dragino/NB-IoT/(threads)

Thread 1 (2018-11-22):

NB-IoT UDP communacation problem

mhmtkrl, 2018-11-22:
Hi,

Thank you for sharing information. I have a quectel BC95-G nb-iot dev board. I followed your tutorial. I created lua script and I tried to send udp message from my nb-iot devices but I didn't success. After send AT+NSOST command, the return value is [socket],[length], OK. I don't receive the "+NSONMI”. I chose the IPv4 address of my computer. AT+CEREG's return value is "+CEREG:1,9129,0AAE9CA1,9", according to this value registration has done. But I need a help.

Thank you in advance.
