dragino/NB-IoT/NB-IoT Shield/hardware/IoT Shield/v1.2/IoT Shield.v1.2 SCH.pdf

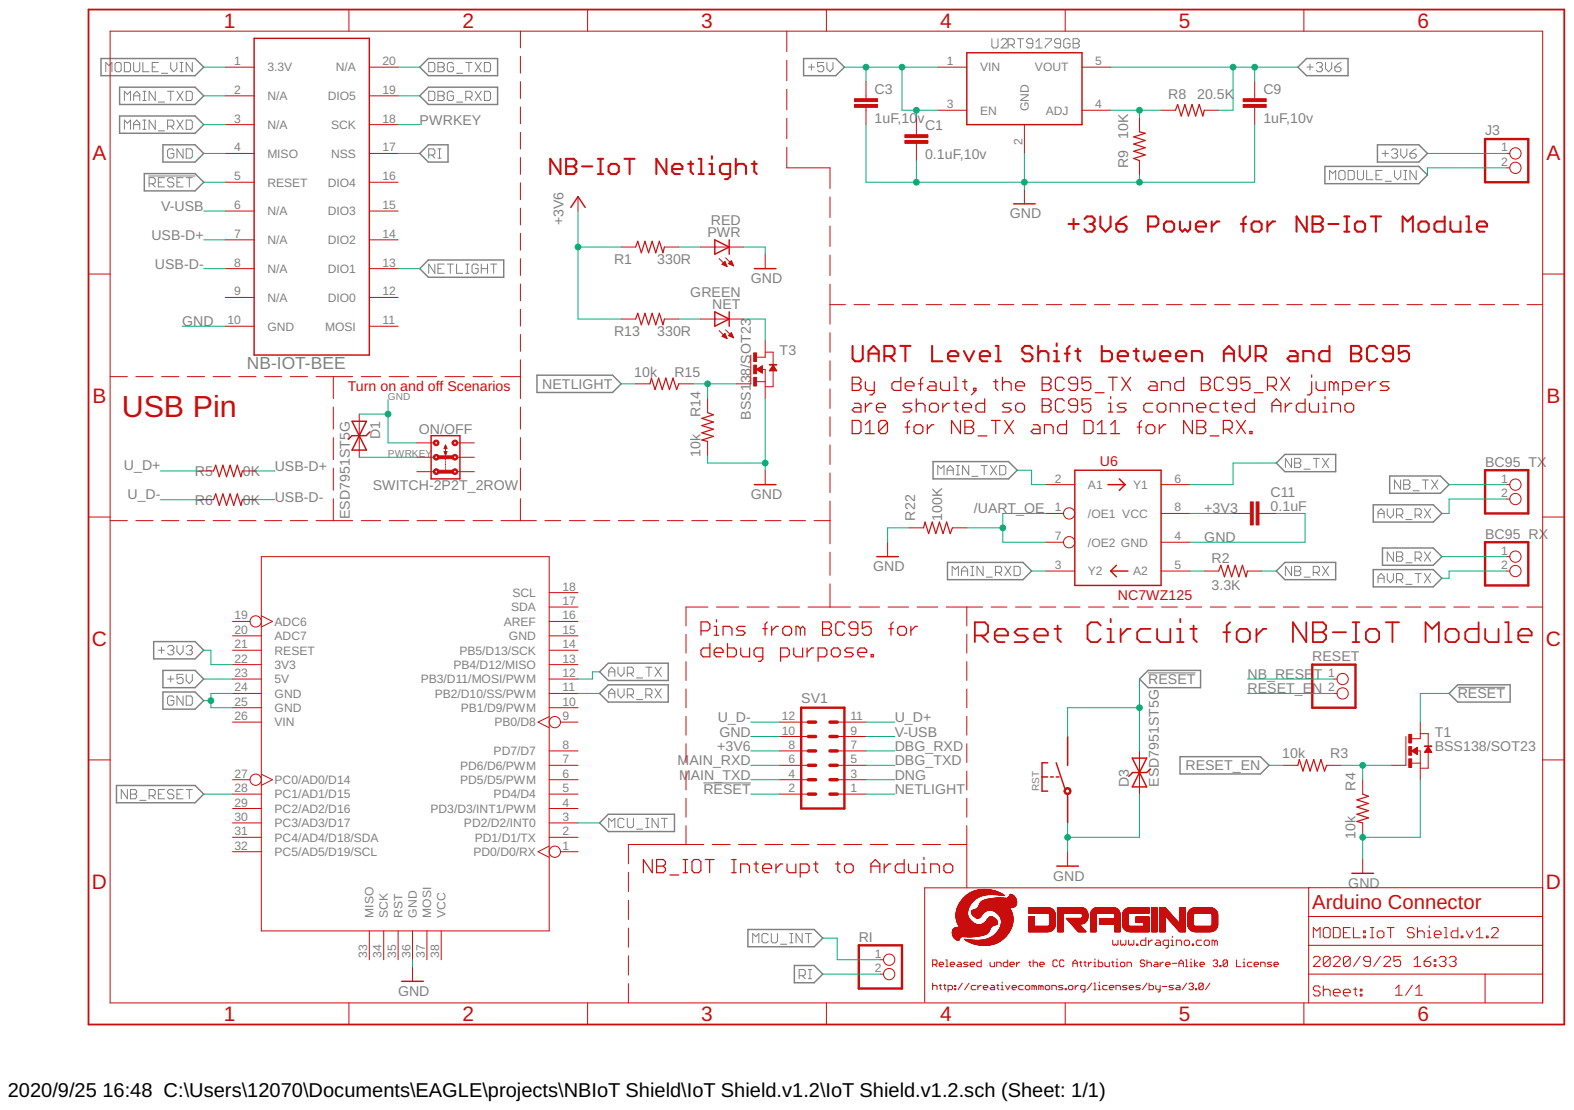
[picture p1: page 1]

Turn on and off Scenarios

2020/9/25 16:48 C:\Users\12070\Documents\EAGLE\projects\NBIoT Shield\IoT Shield.v1.2\IoT Shield.v1.2.sch (Sheet: 1/1)
