dragino/NB-IoT/NB-IoT Shield/hardware/IoT Shield/v1.2/IoT Shield.v1.2 top_silkscreen.pdf

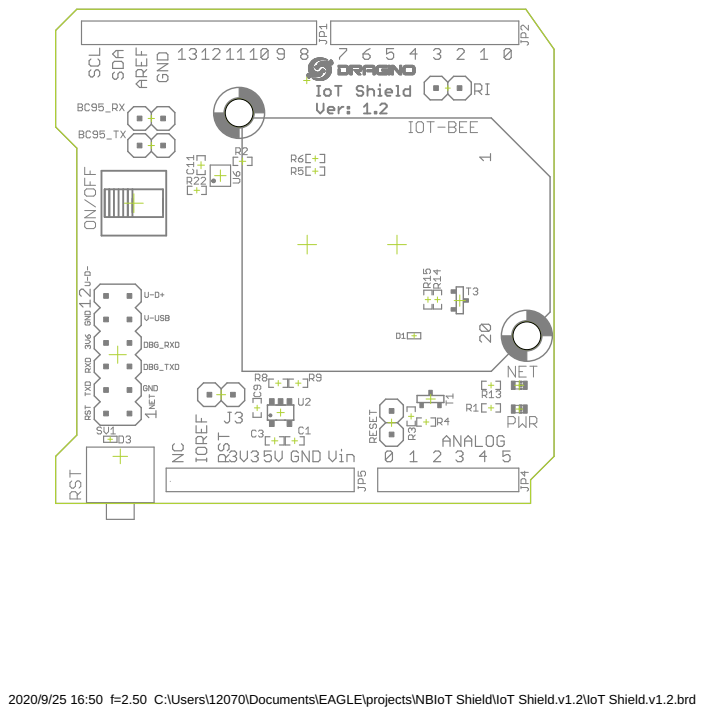
[picture p2: page 1]

2020/9/25 16:50 f=2.50 C:\Users\12070\Documents\EAGLE\projects\NBIoT Shield\IoT Shield.v1.2\IoT Shield.v1.2.brd
