dragino/NB-IoT/NB-IoT Shield/hardware/NB-IoT Bee/v96_5/NB-IoT Bee.v96_5.sch.pdf

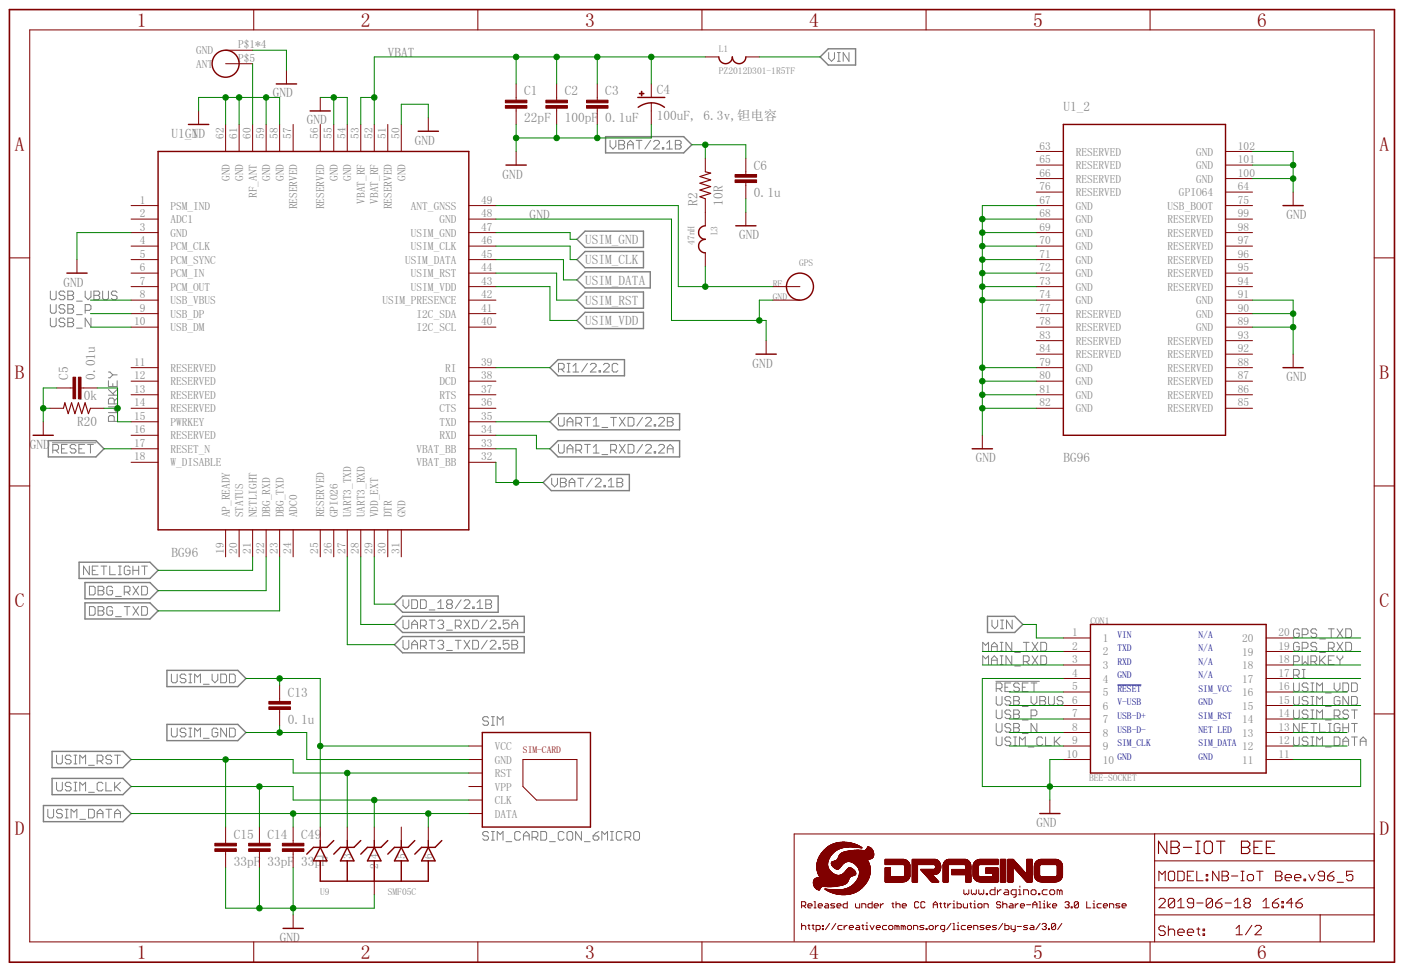
[picture p3: page 1]

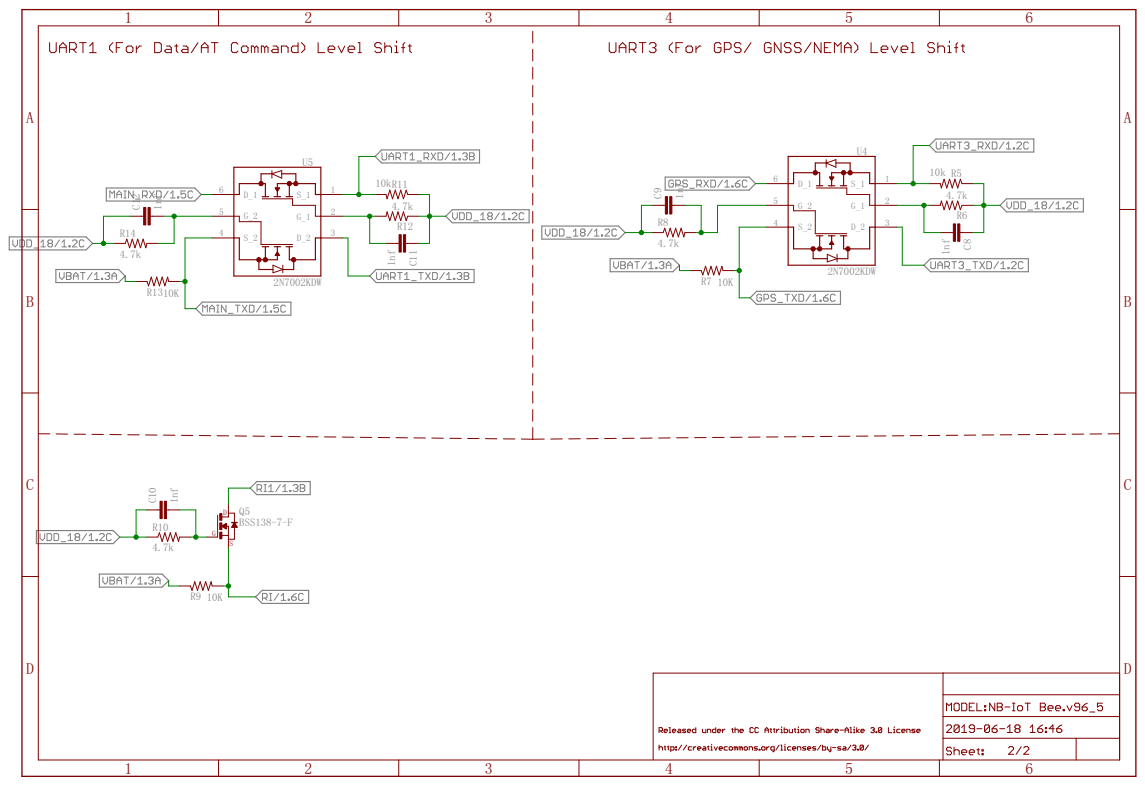
[picture p4: page 2]
