dragino/NB-IoT/NB ST/BG95-NGFF v1.0/BG95-NGFF v1.0 bottom_silkscreen.pdf

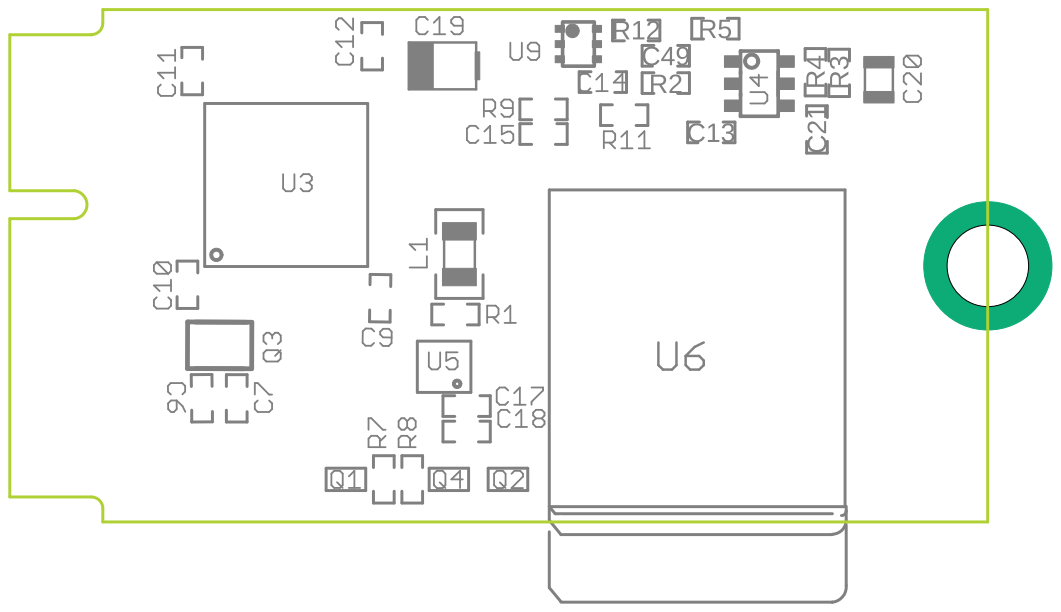
[picture p5: page 1]
