dragino/NB-IoT/NB ST/BG95-NGFF v1.0/BG95-NGFF v1.0 topsilkscreen.pdf

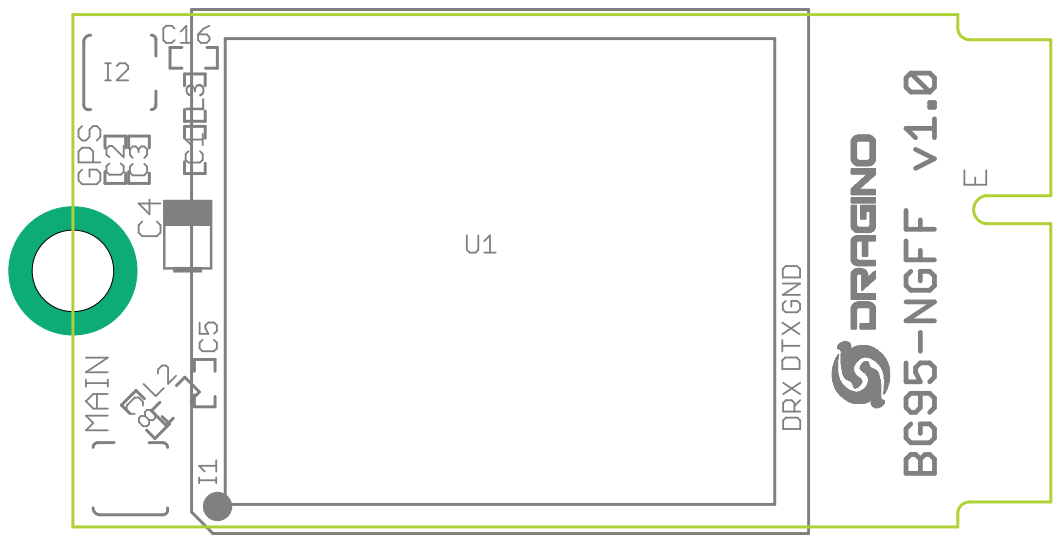
[picture p6: page 1]
