dragino/NB-IoT/NB ST/BG95-NGFF v1.0/BG95-NGFF v1.0.sch.pdf

A

A

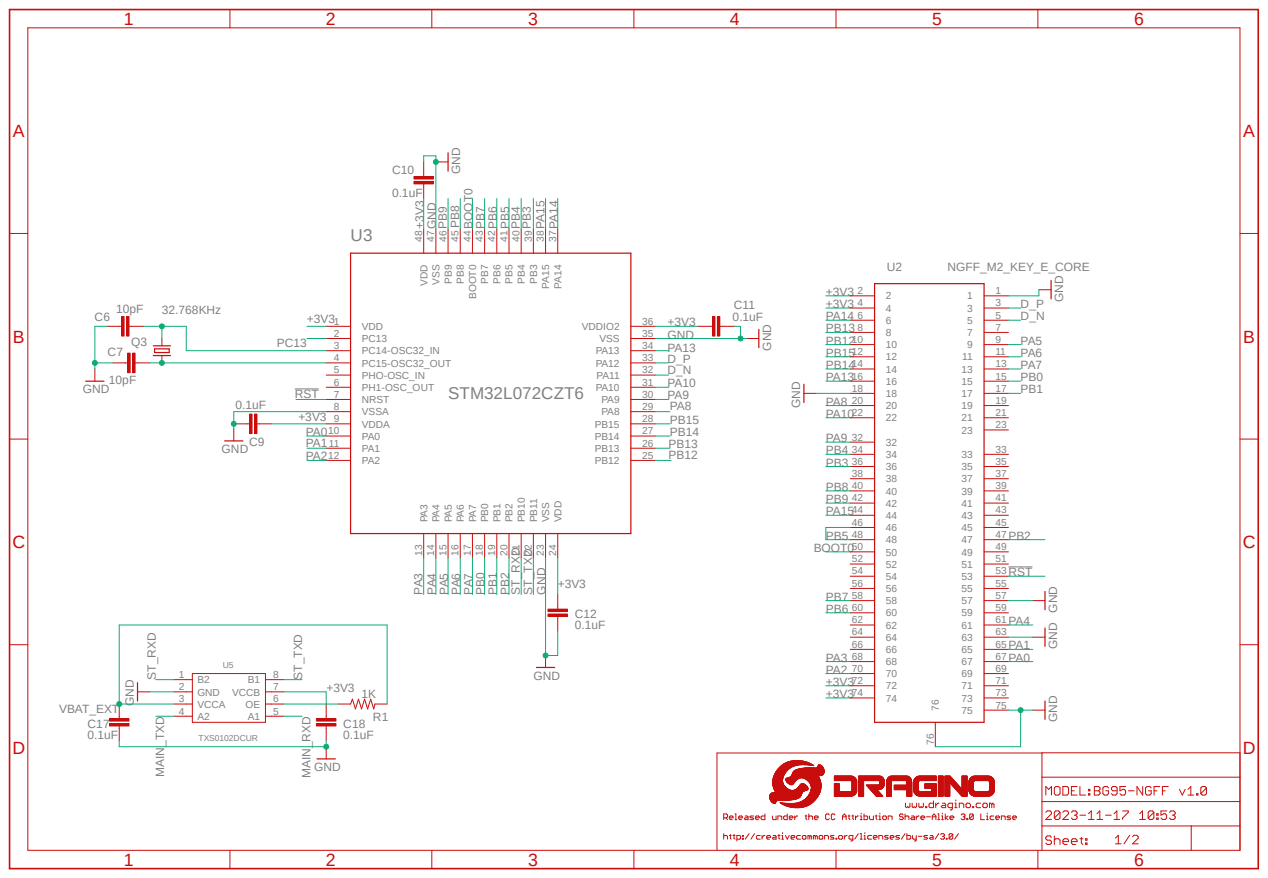
[picture p7: page 1]

A

A

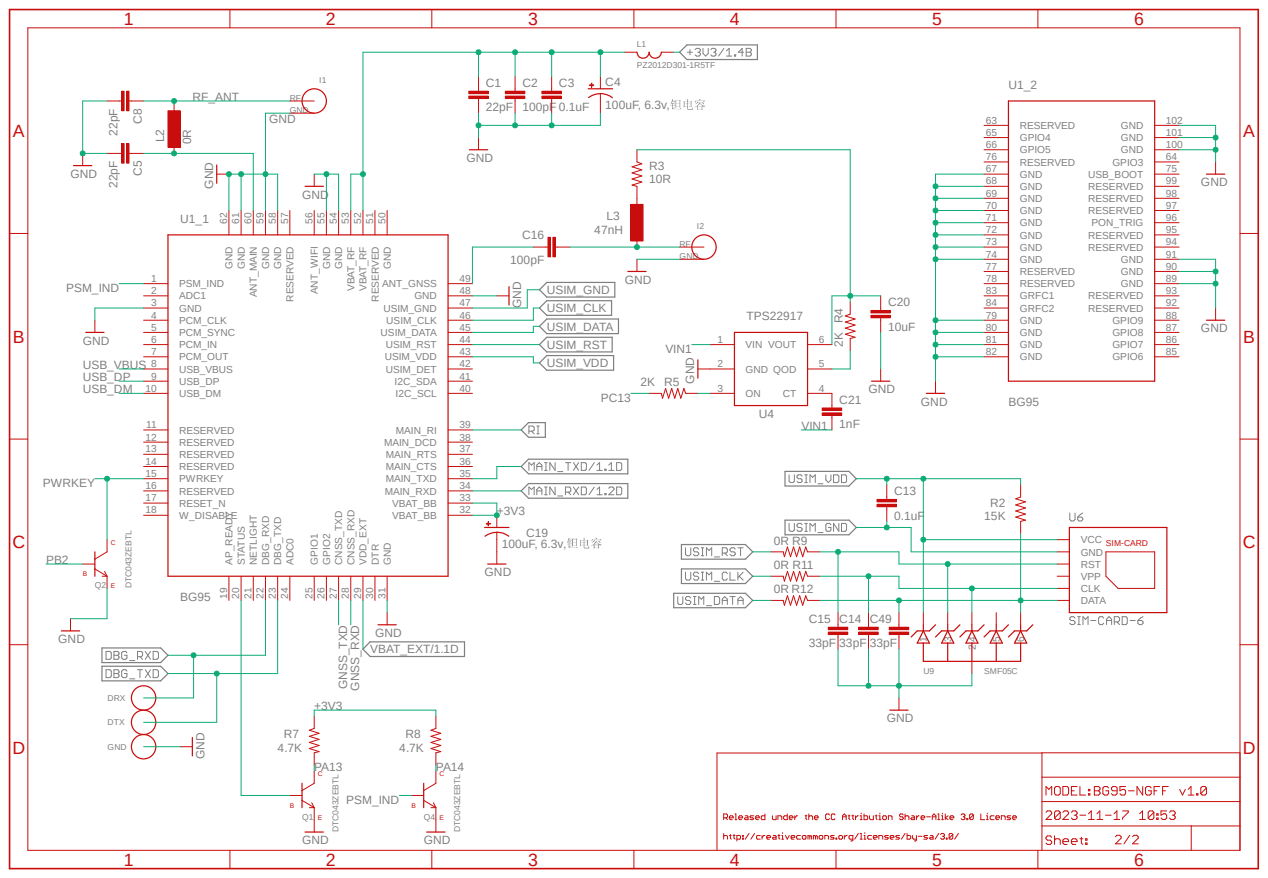
[picture p8: page 2]
