dragino/NB-IoT/NB ST/BC660K-GL/v1.3/NB ST v1.3-BC660K-GL bottom_silkscreen.pdf

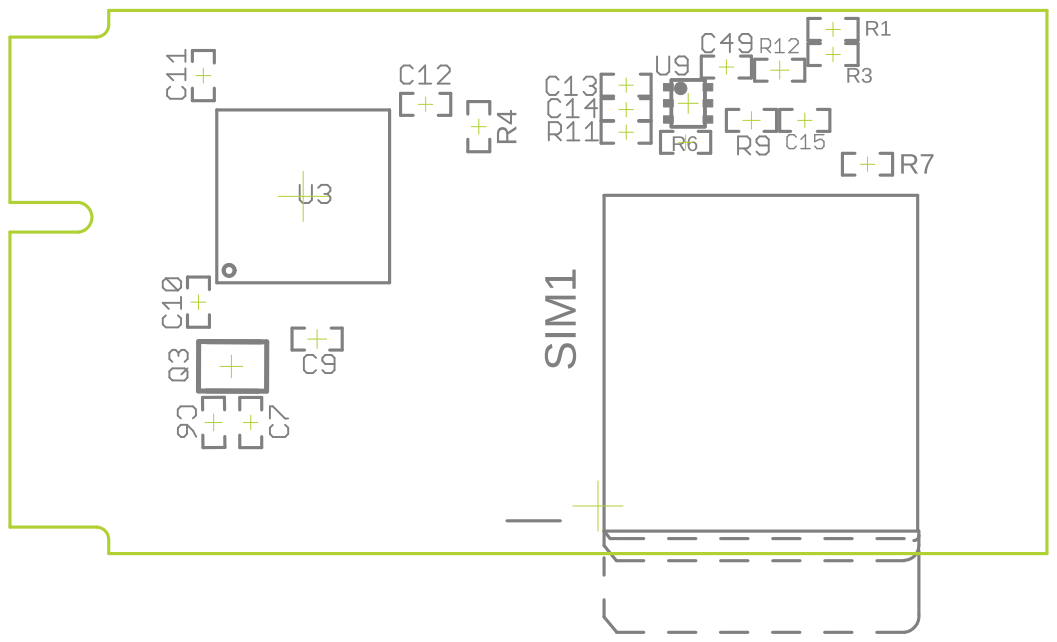
[picture p9: page 1]
