dragino/NB-IoT/NB ST/BC660K-GL/v1.3/NB ST v1.3-BC660K-GL top_silkscreen.pdf

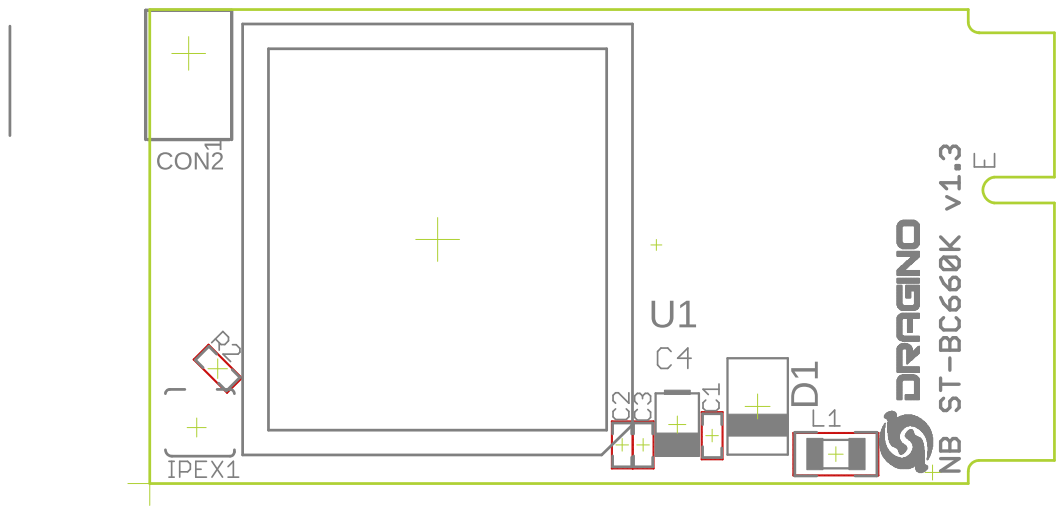
[picture p10: page 1]
