dragino/NB-IoT/NB ST/BC660K-GL/v1.3/NB ST v1.3-BC660K-GL.sch.pdf

A

A

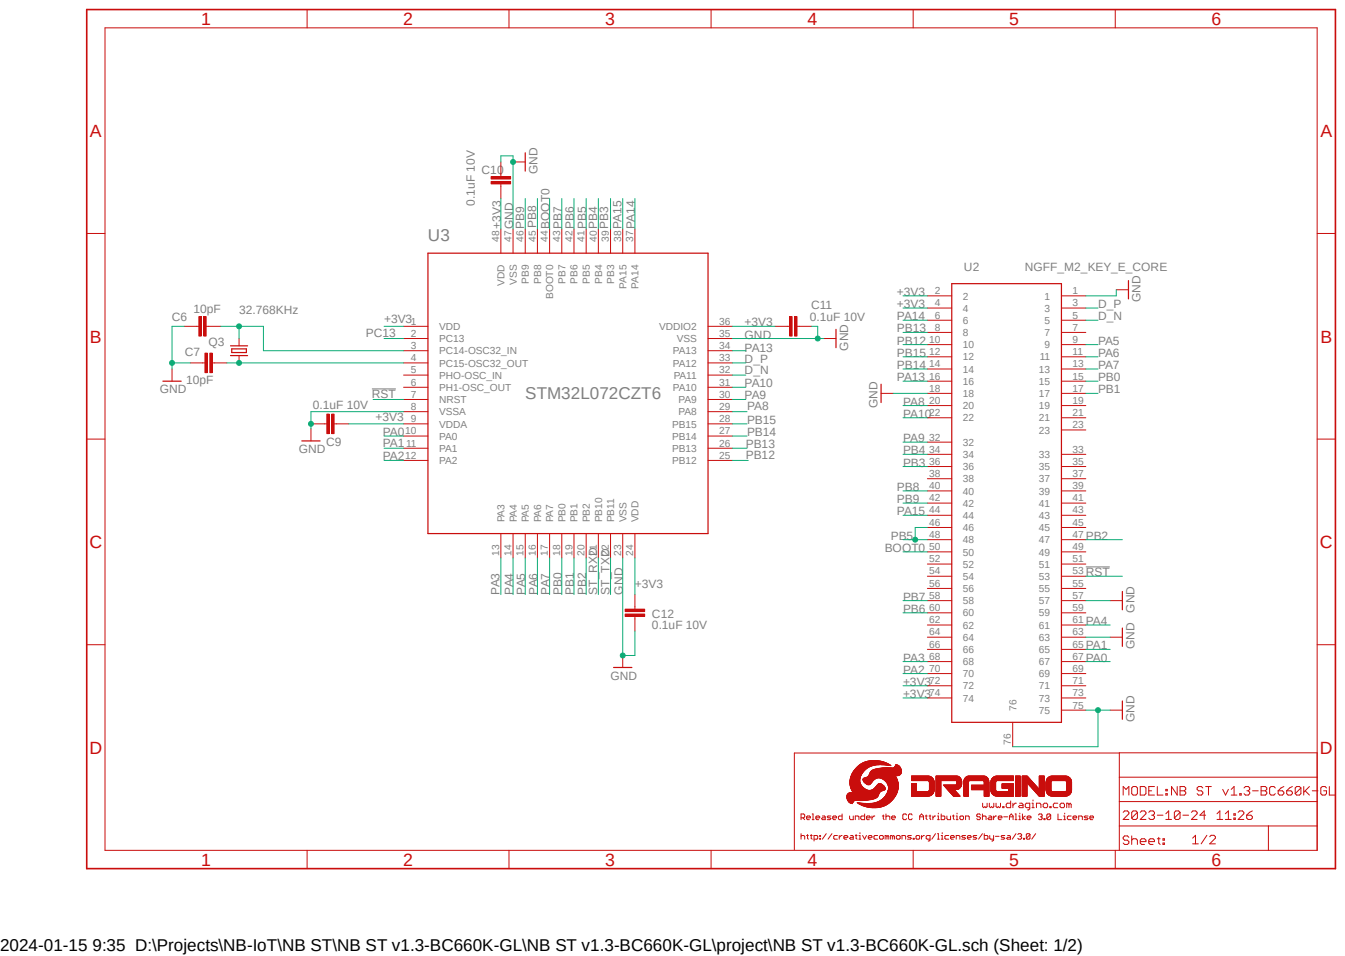
[picture p11: page 1]

2024-01-15 9:35 D:\Projects\NB-IoT\NB ST\NB ST v1.3-BC660K-GL\NB ST v1.3-BC660K-GL\project\NB ST v1.3-BC660K-GL.sch (Sheet: 1/2)

A

A

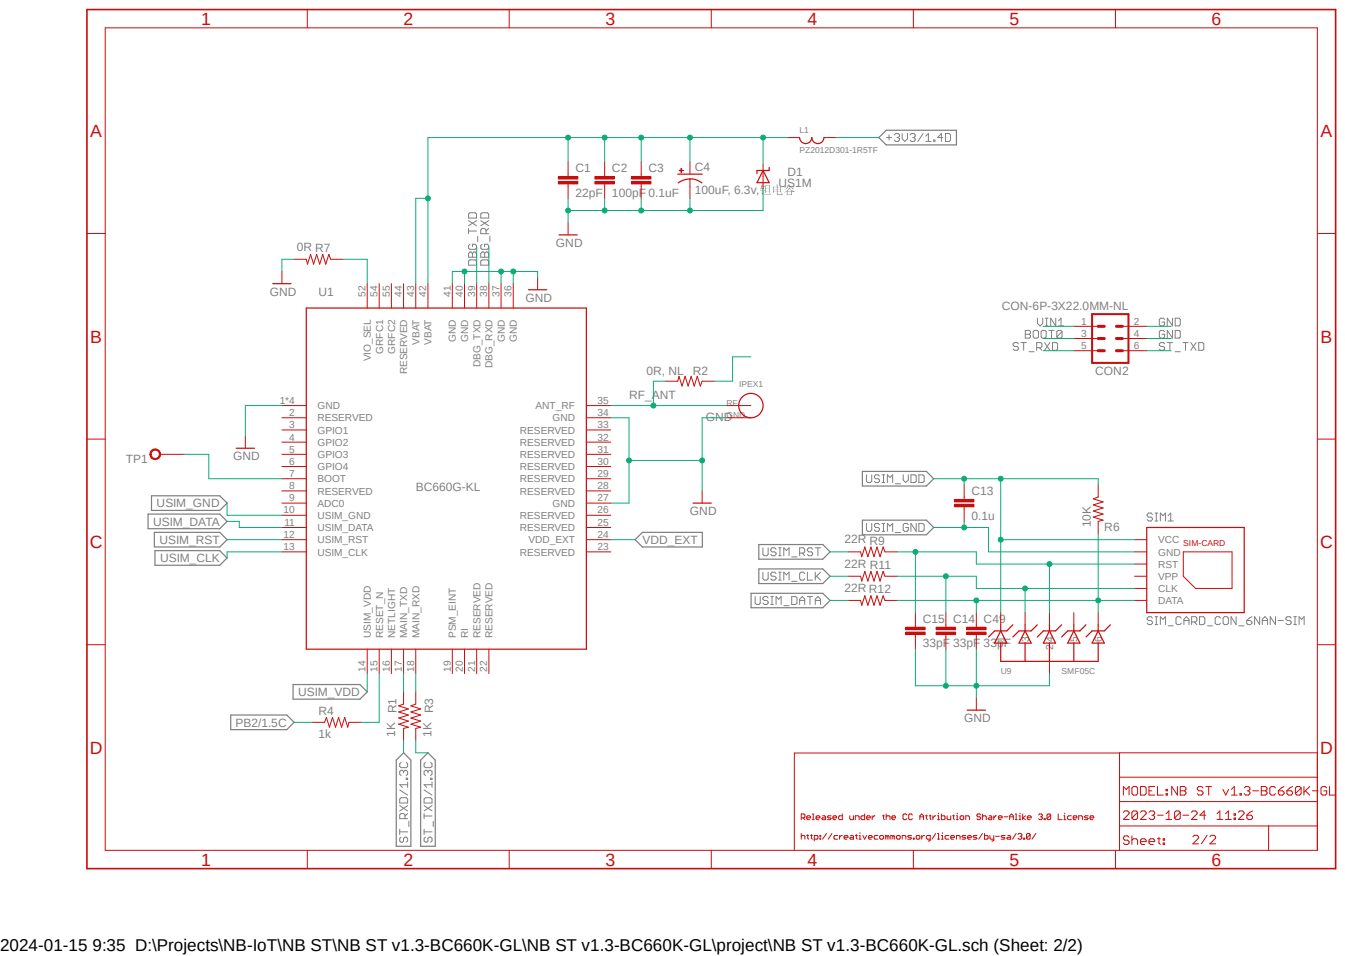
[picture p12: page 2]

2024-01-15 9:35 D:\Projects\NB-IoT\NB ST\NB ST v1.3-BC660K-GL\NB ST v1.3-BC660K-GL\project\NB ST v1.3-BC660K-GL.sch (Sheet: 2/2)
