dragino/NB-IoT/NB ST/BC95/v1.1/NB ST v1.1 bottomsilkscreen.pdf

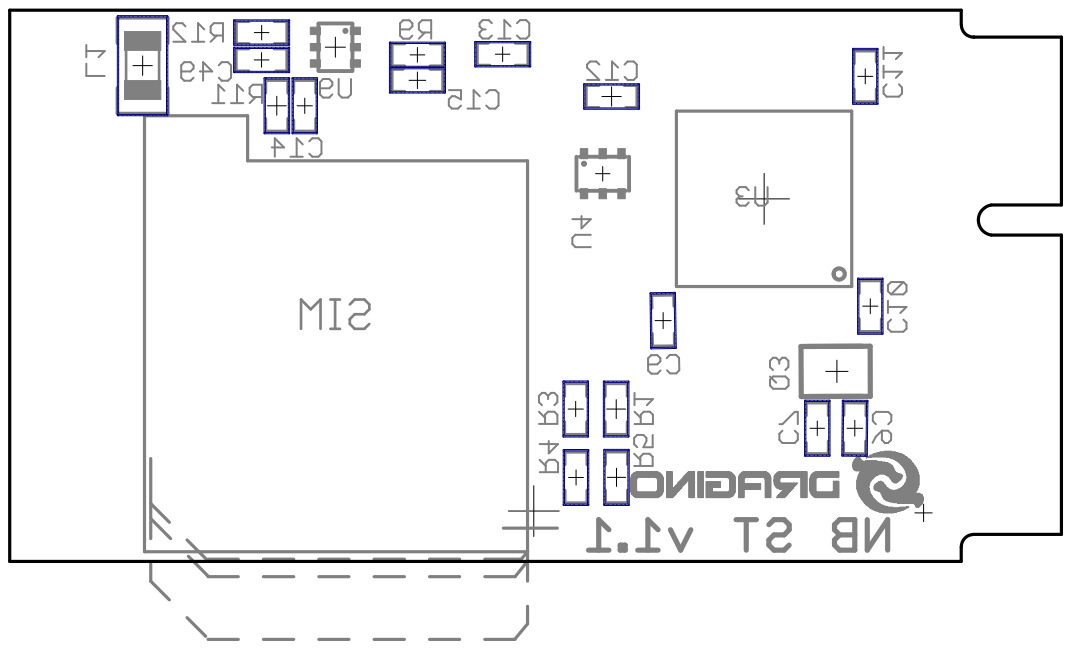
[picture p13: page 1]
