dragino/NB-IoT/NB ST/BC95/v1.1/NB ST v1.1 topsilkscreen.pdf

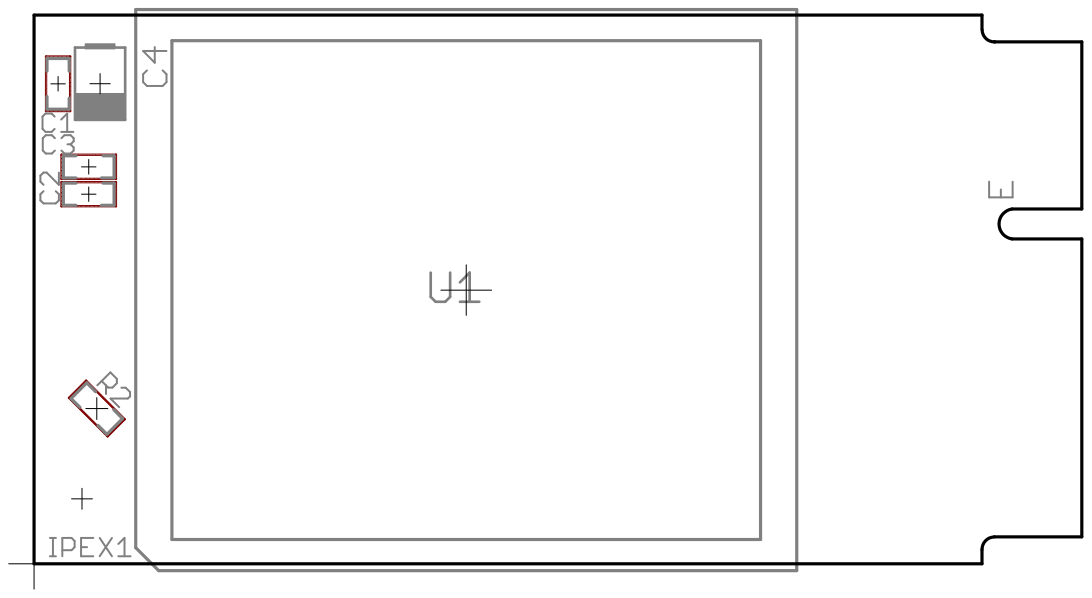
[picture p14: page 1]
