dragino/NB-IoT/NB ST/BC95/v1.1/NB ST v1.1.sch.pdf

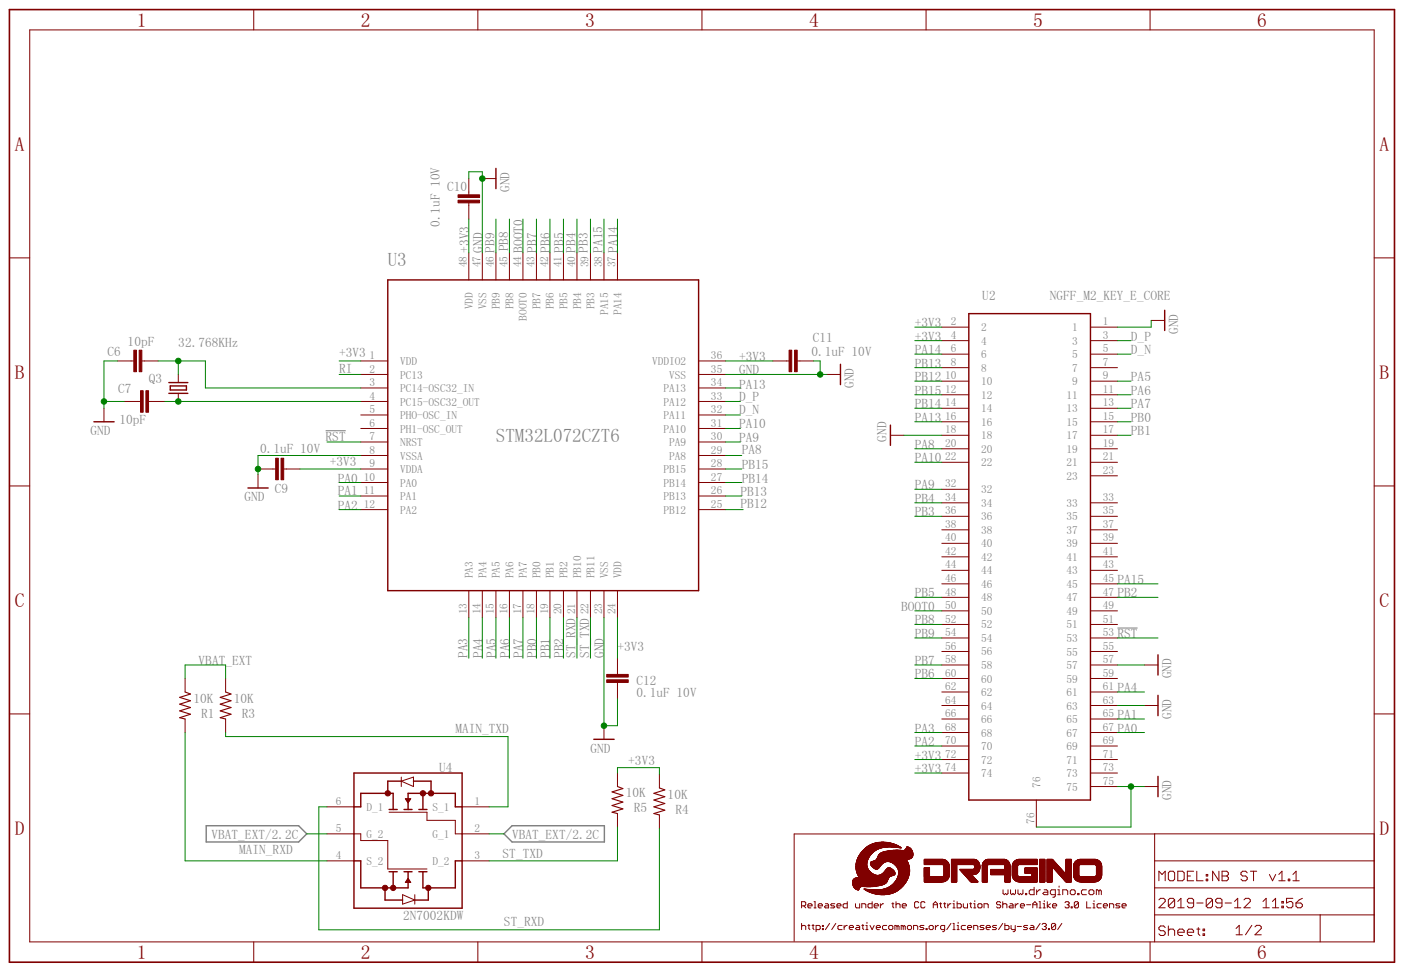
[picture p15: page 1]

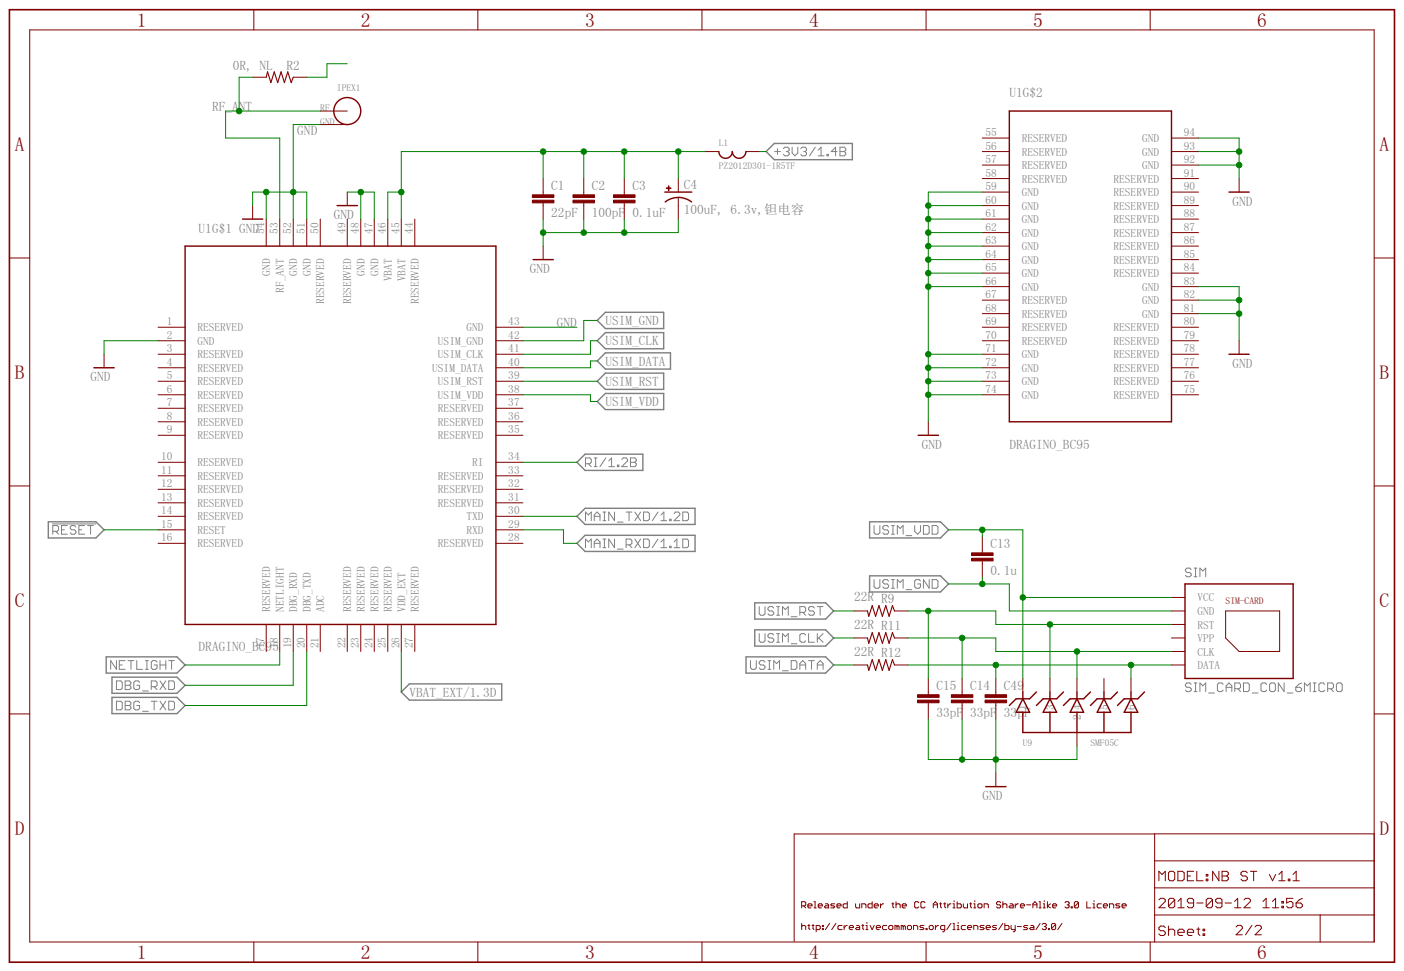
[picture p16: page 2]
