dragino/NB-IoT/NB-IoT Shield/hardware/NB-IoT Bee/v96_4/NB-IoT Bee.v96_4.bot.silkscreen.pdf

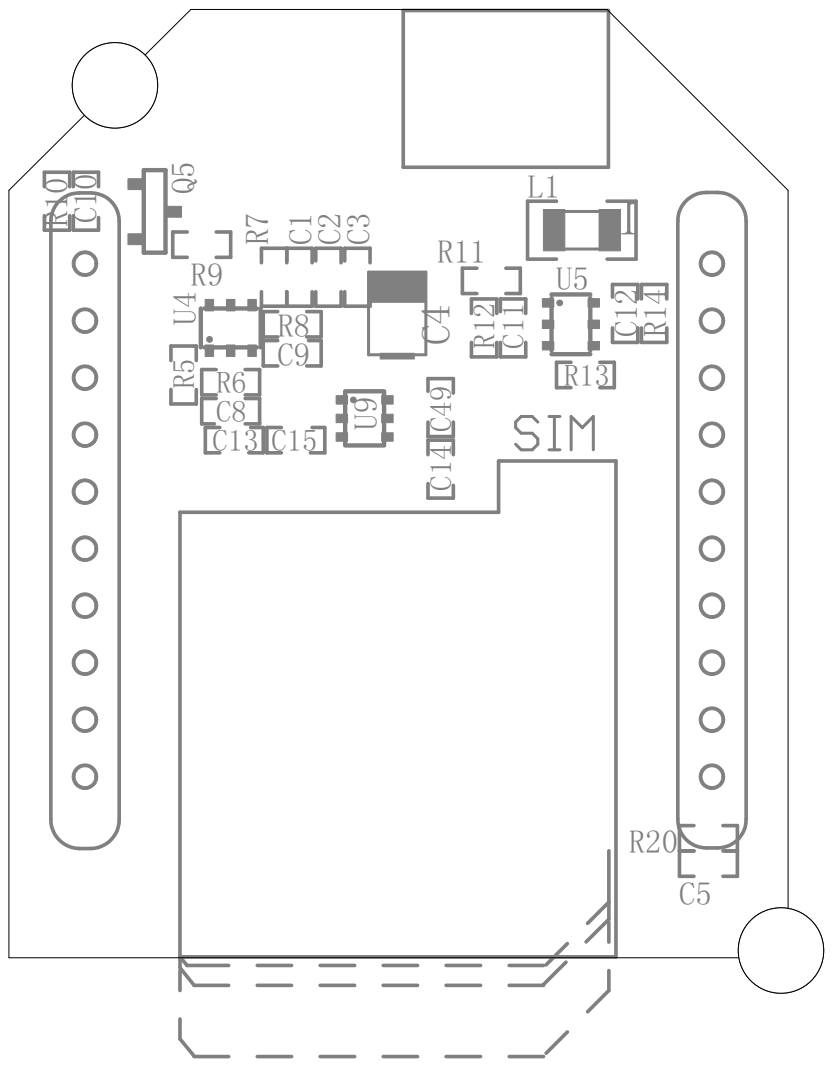
[picture p17: page 1]
