dragino/NB-IoT/NB-IoT Shield/hardware/NB-IoT Bee/v96_4/NB-IoT Bee.v96_4.sch.pdf

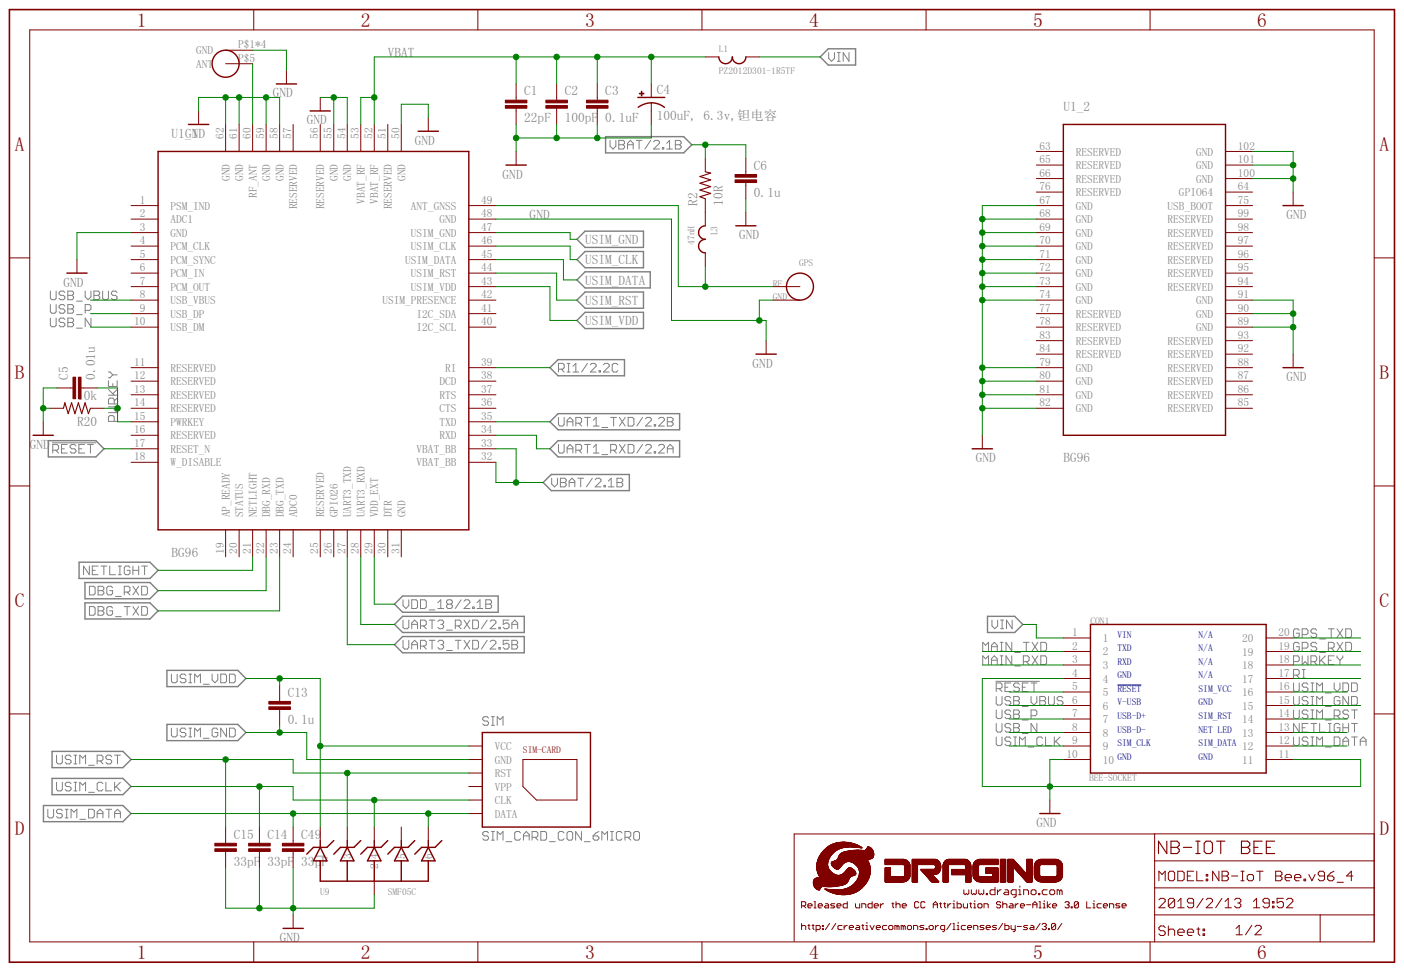
[picture p18: page 1]

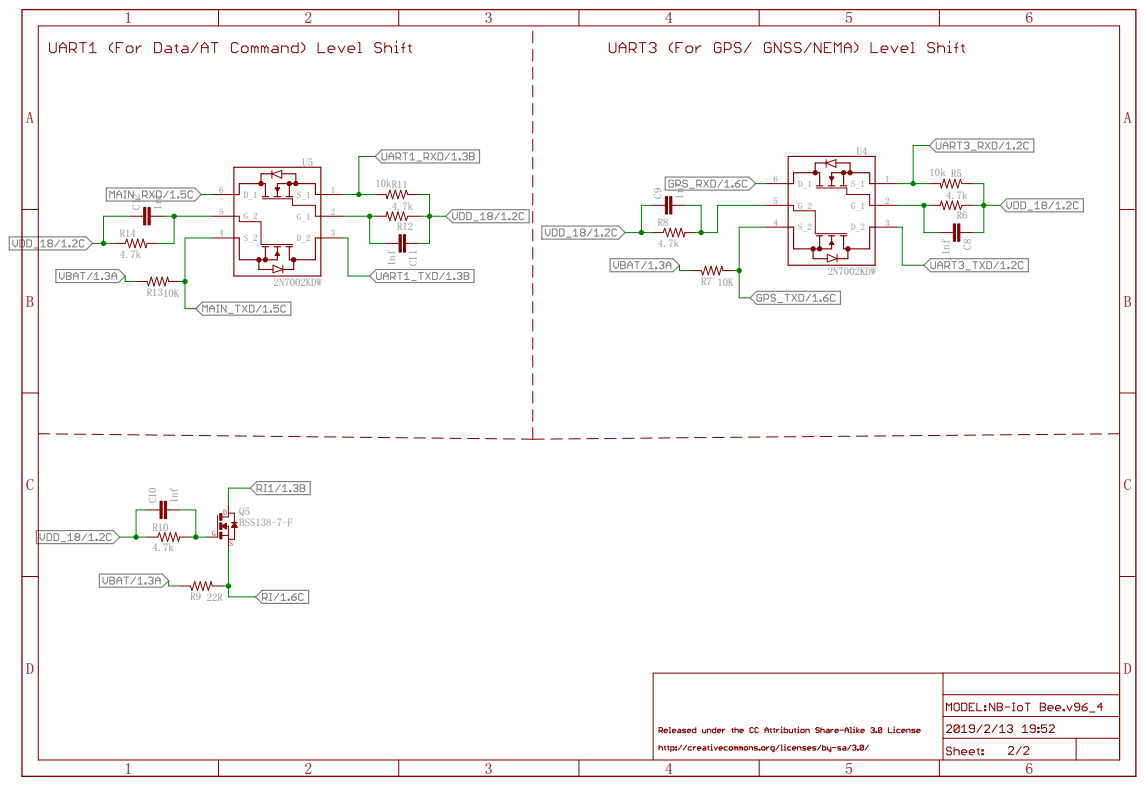
[picture p19: page 2]
