dragino/NB-IoT/NB-IoT Shield/hardware/NB-IoT Bee/v96_4/NB-IoT Bee.v96_4.top.silkscreen.pdf

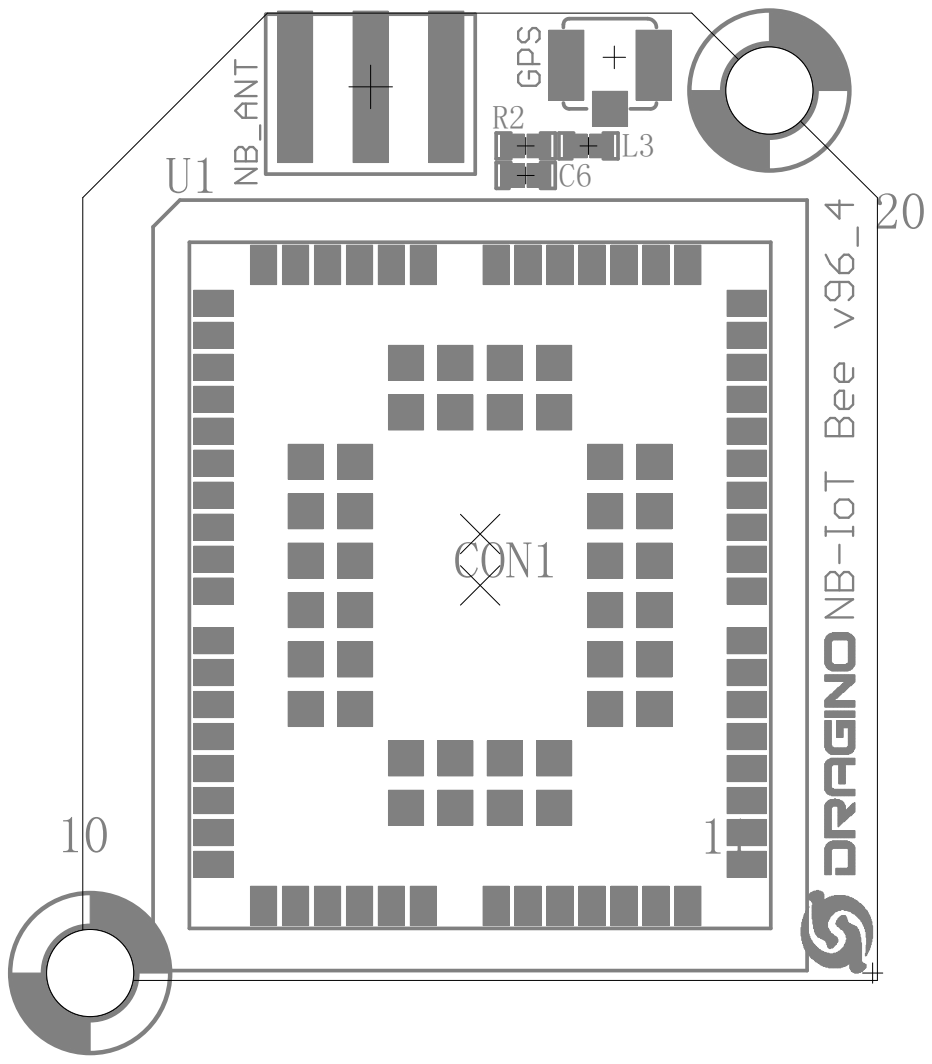
[picture p20: page 1]
