dragino/NB-IoT/NB-IoT Shield/hardware/NB-IoT Bee/v96_3/NB-IoT Bee.v96_3.bot.silkscreen.pdf

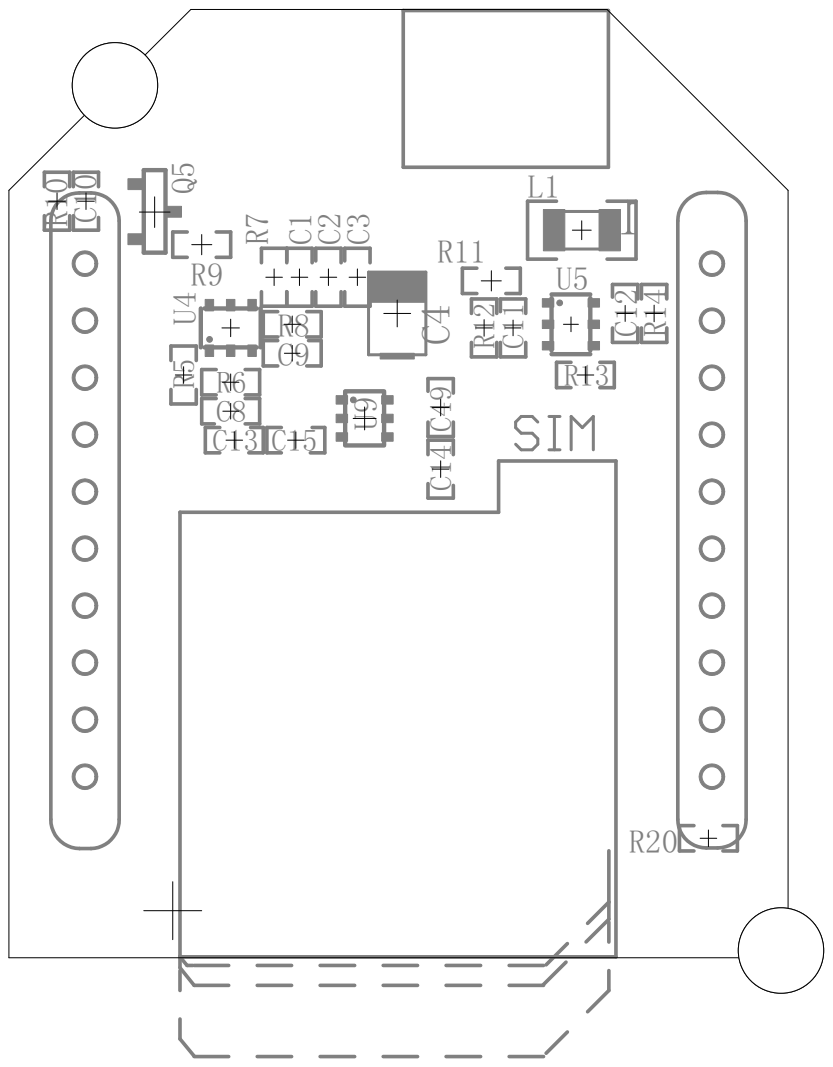
[picture p21: page 1]
