dragino/NB-IoT/NB-IoT Shield/hardware/NB-IoT Bee/v96_3/NB-IoT Bee.v96_3.sch.pdf

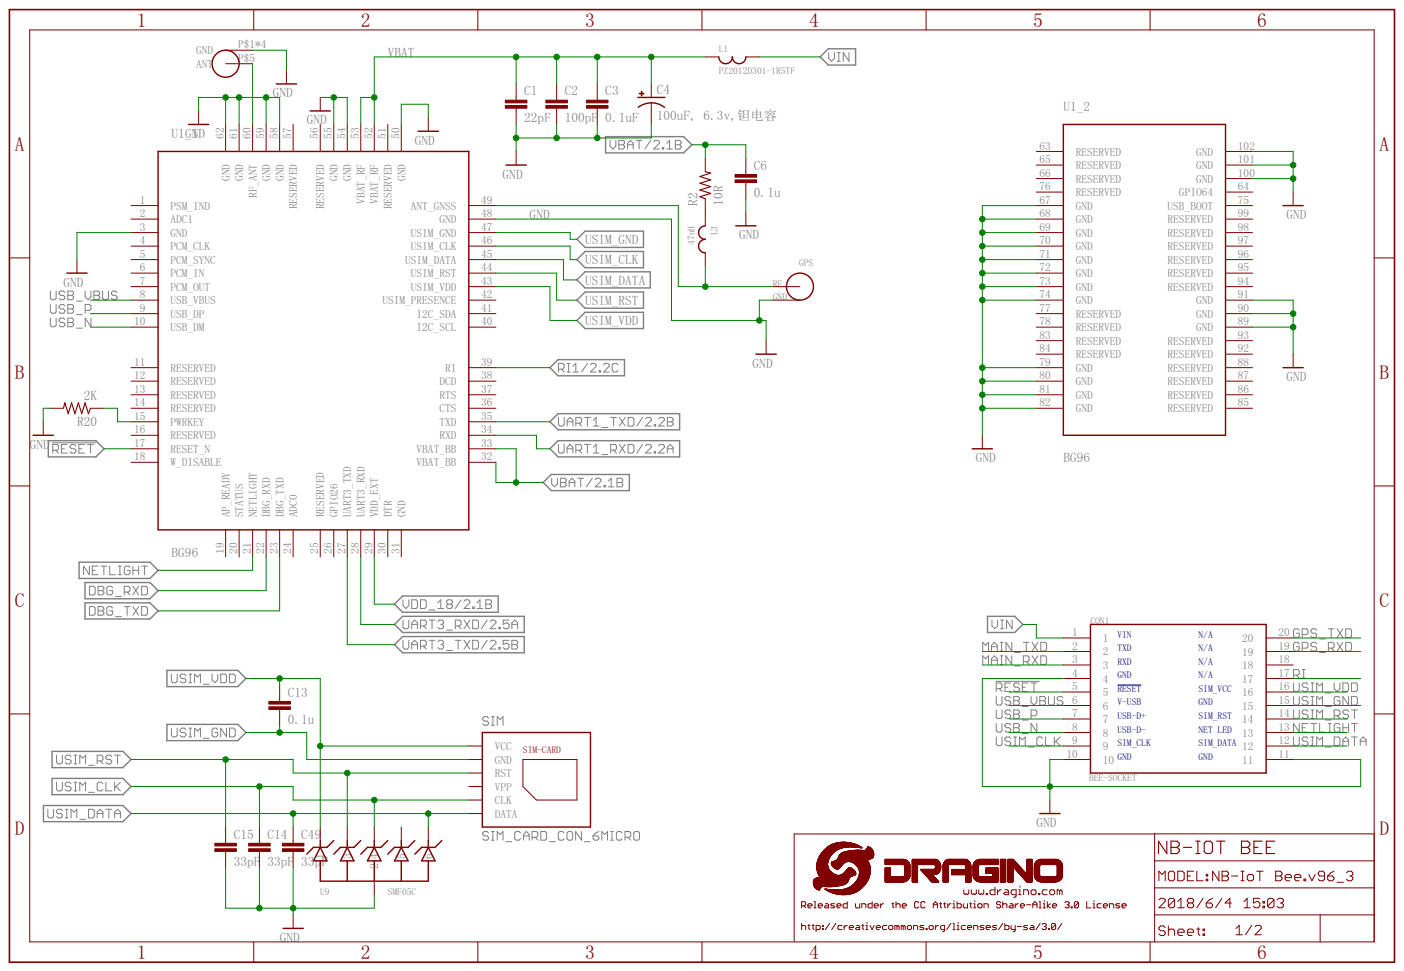
[picture p22: page 1]

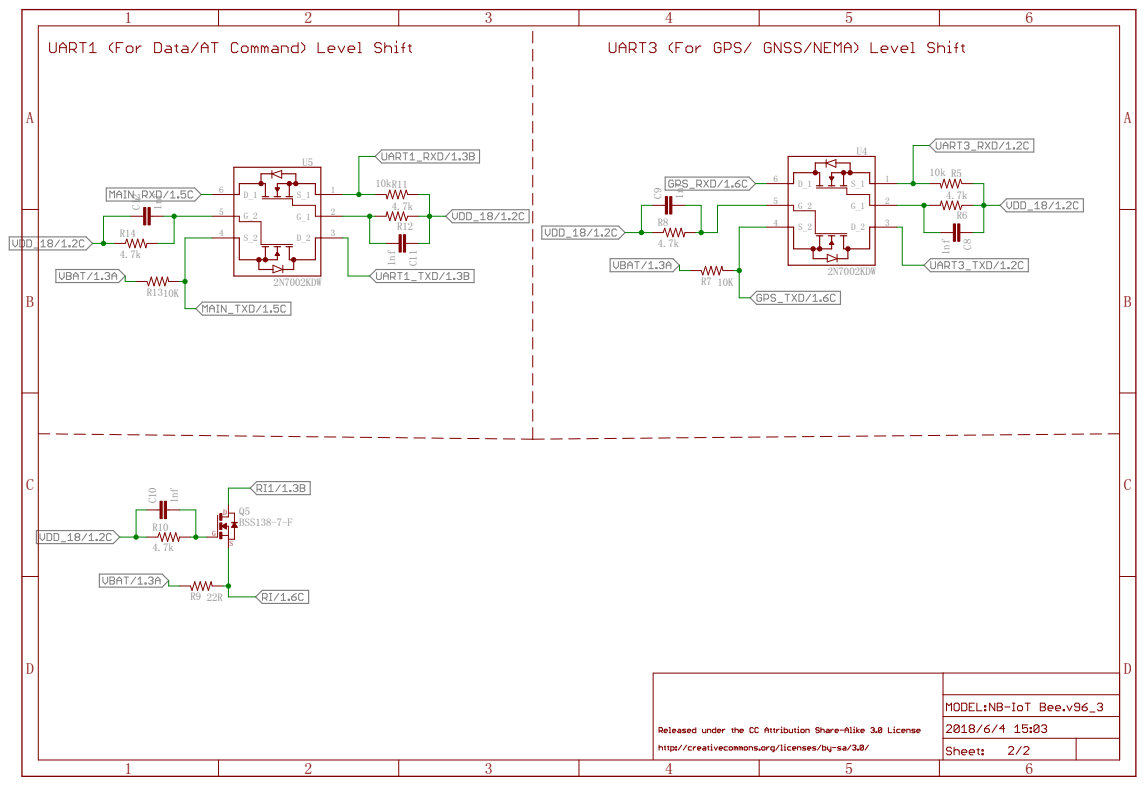
[picture p23: page 2]
