dragino/NB-IoT/NB-IoT Shield/hardware/NB-IoT Bee/v96_3/NB-IoT Bee.v96_3.top.silkscreen.pdf

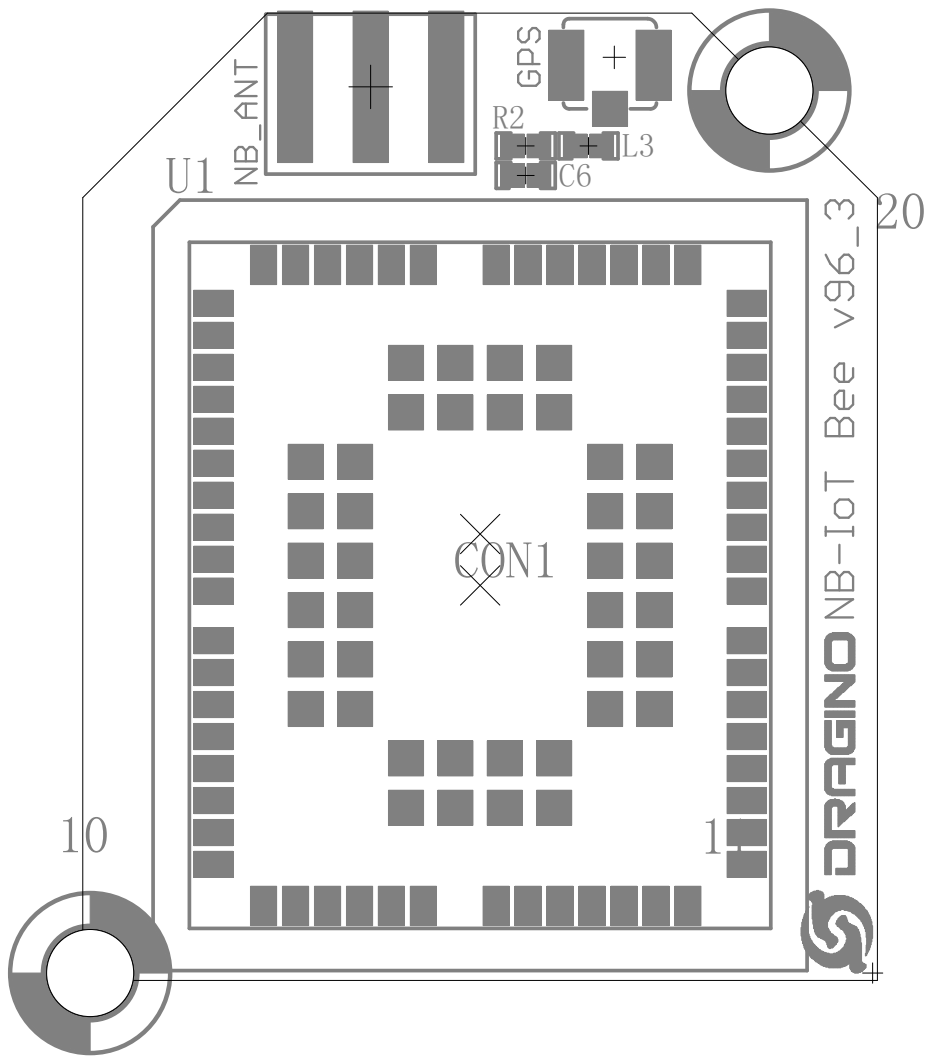
[picture p24: page 1]
