dragino/NB-IoT/NB-IoT Shield/hardware/IoT Shield/v1.0/IoT Shield.v1.0.sch.pdf

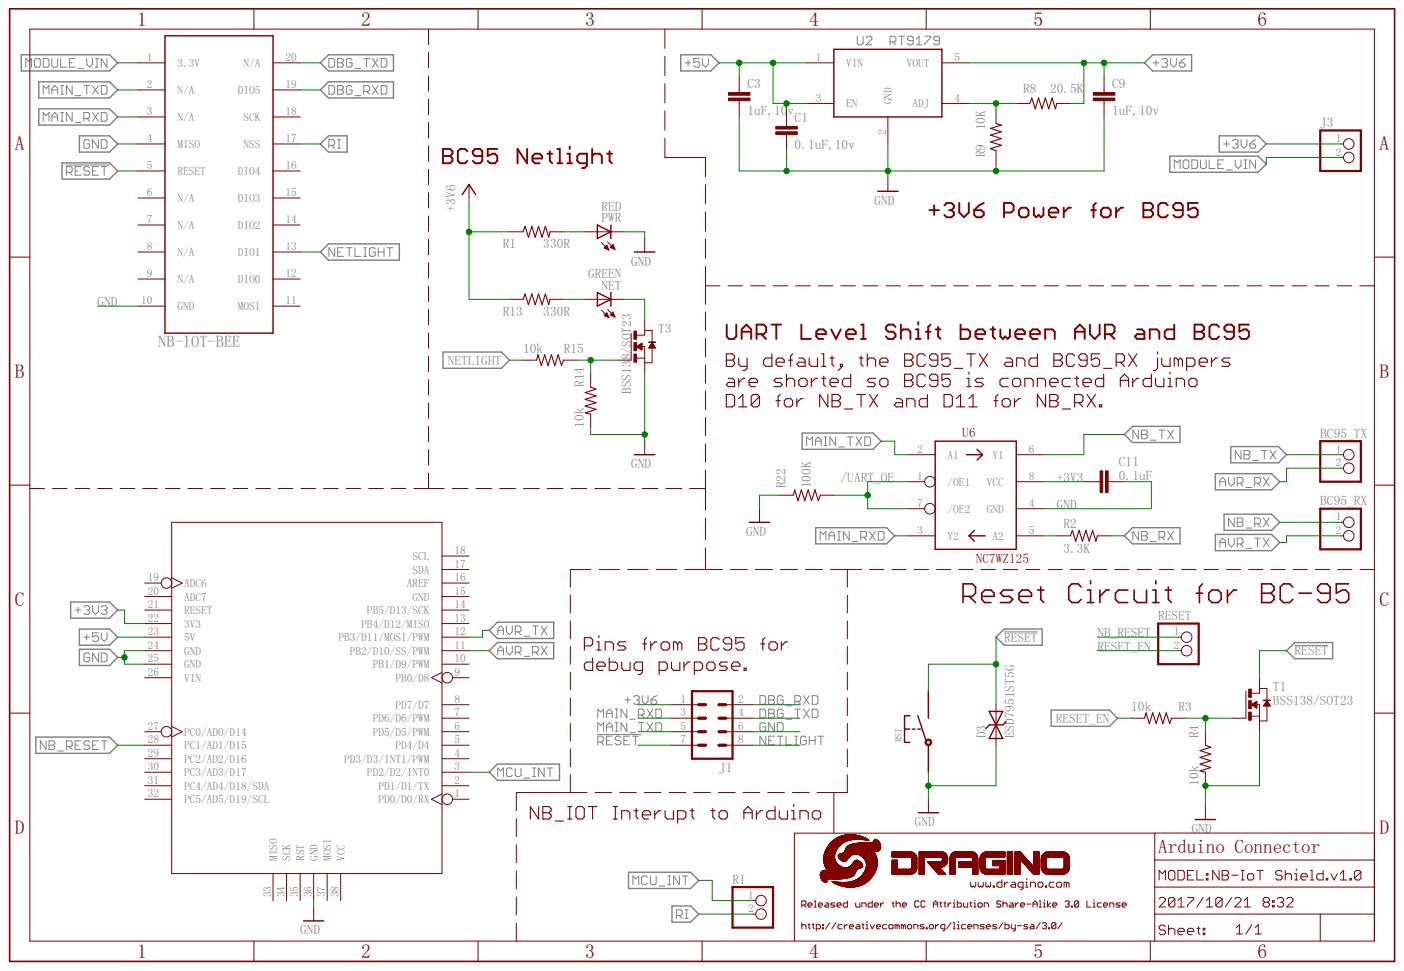
[picture p25: page 1]
