dragino/NB-IoT/NB-IoT Shield/hardware/IoT Shield/v1.0/IoT Shield.v1.0.top.silkscreen.pdf

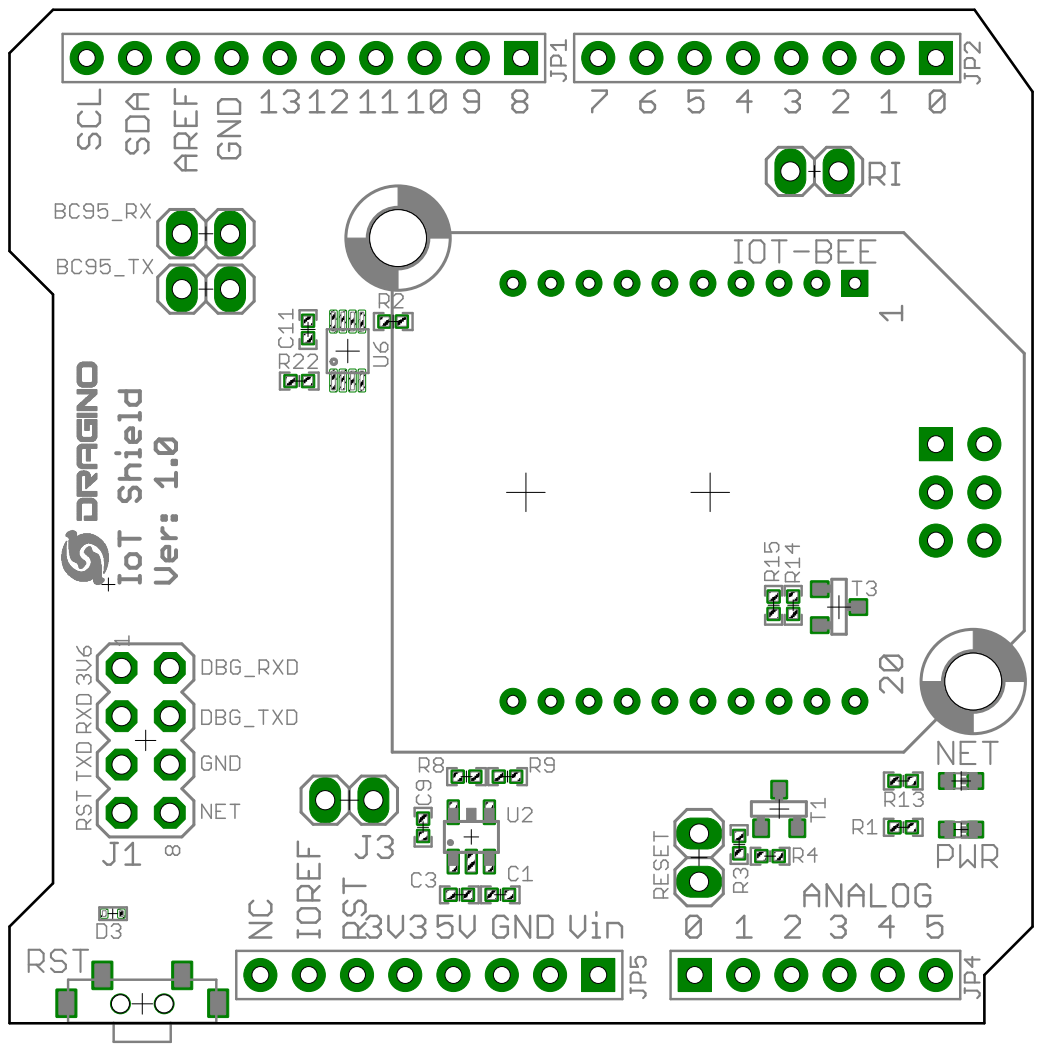
[picture p26: page 1]
