dragino/NB-IoT/NB-IoT Shield/hardware/NB-IoT Bee/v1.0/NB-IoT Bee.v1.0.bot.silkscreen.pdf

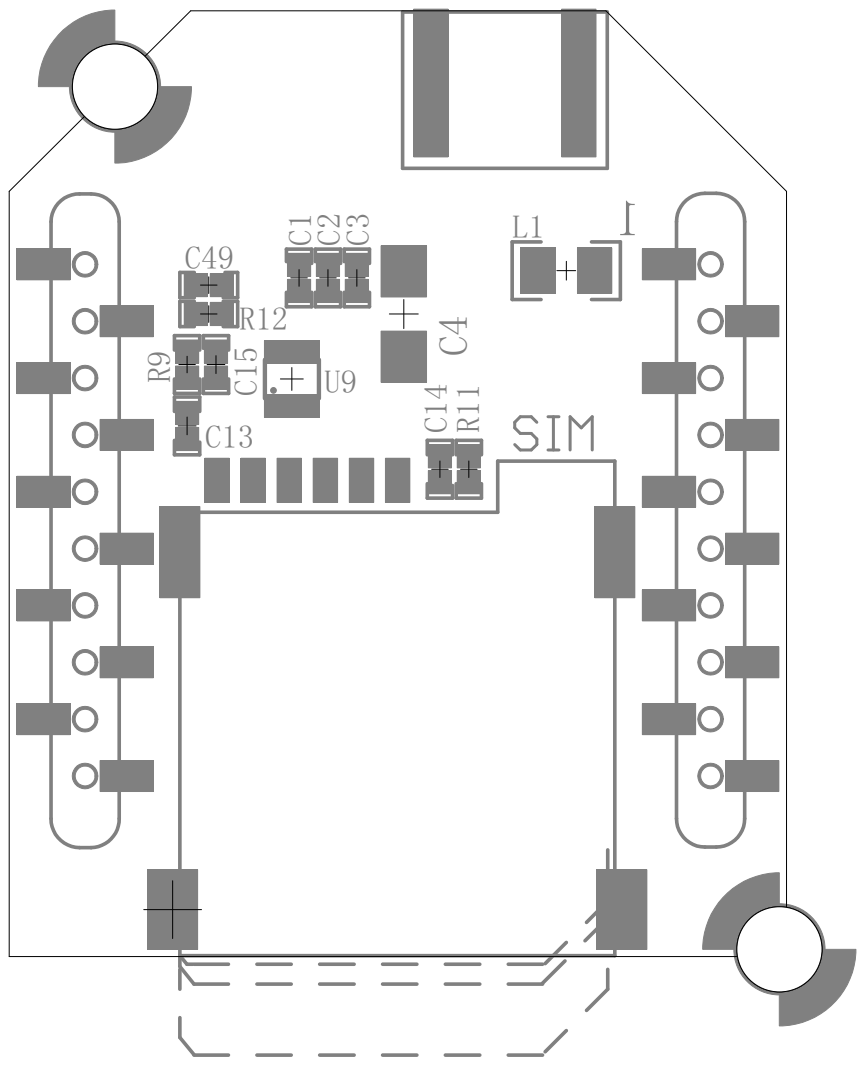
[picture p27: page 1]
