dragino/NB-IoT/NB-IoT Shield/hardware/NB-IoT Bee/v1.0/NB-IoT Bee.v1.0.sch.pdf

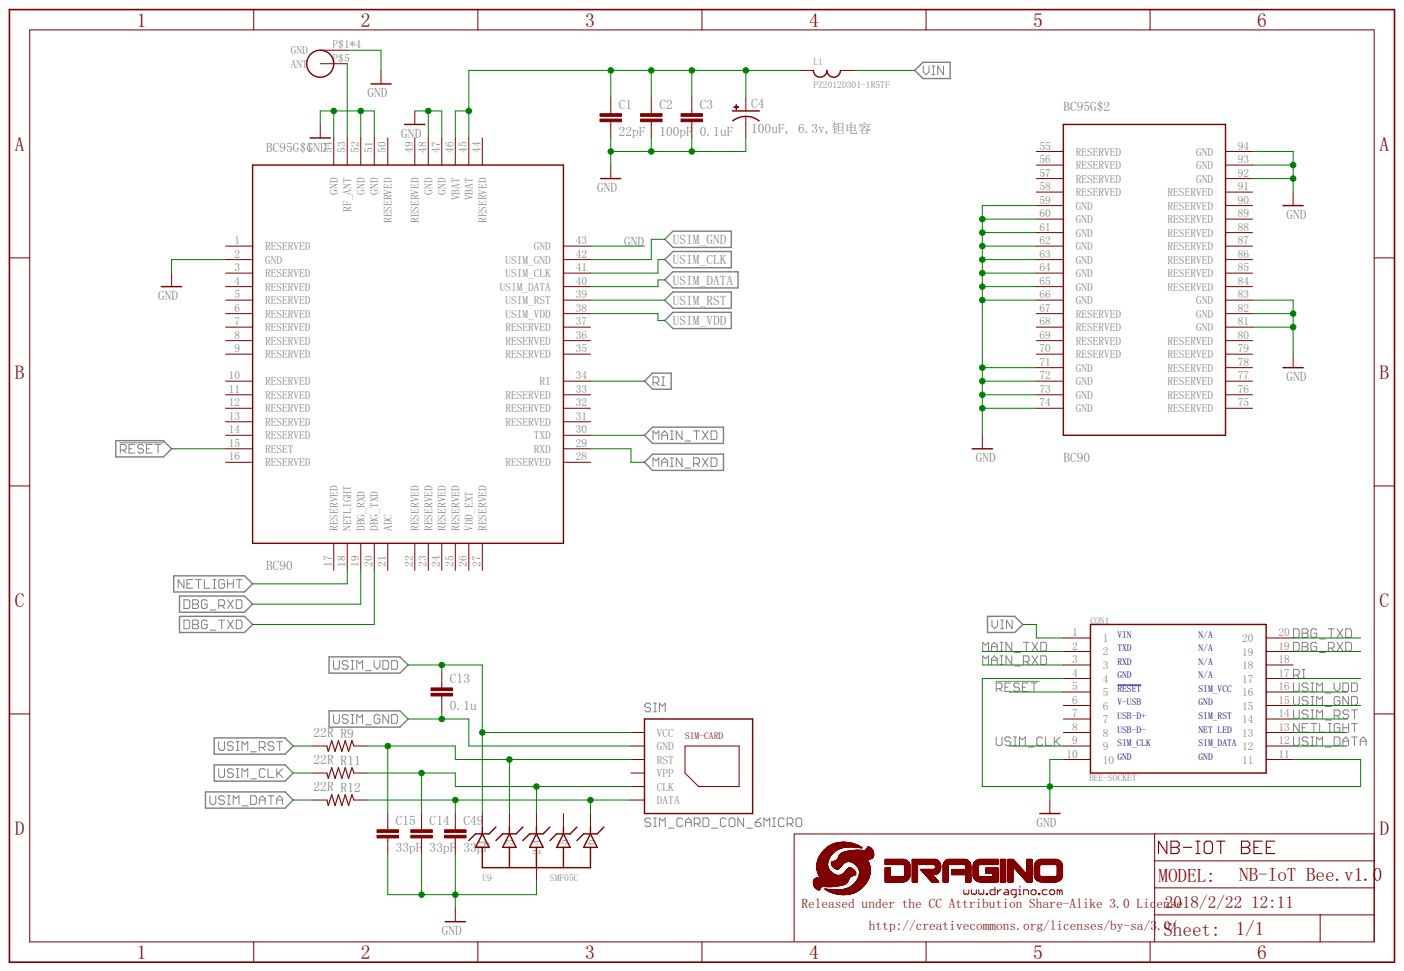
[picture p28: page 1]
