dragino/NB-IoT/NB-IoT Shield/hardware/IoT Shield/v1.2/IoT Shield.v1.2.brd

## EAGLE design NB-IoT Shield/hardware/IoT Shield/v1.2/IoT Shield.v1.2.brd (2021-01-21)

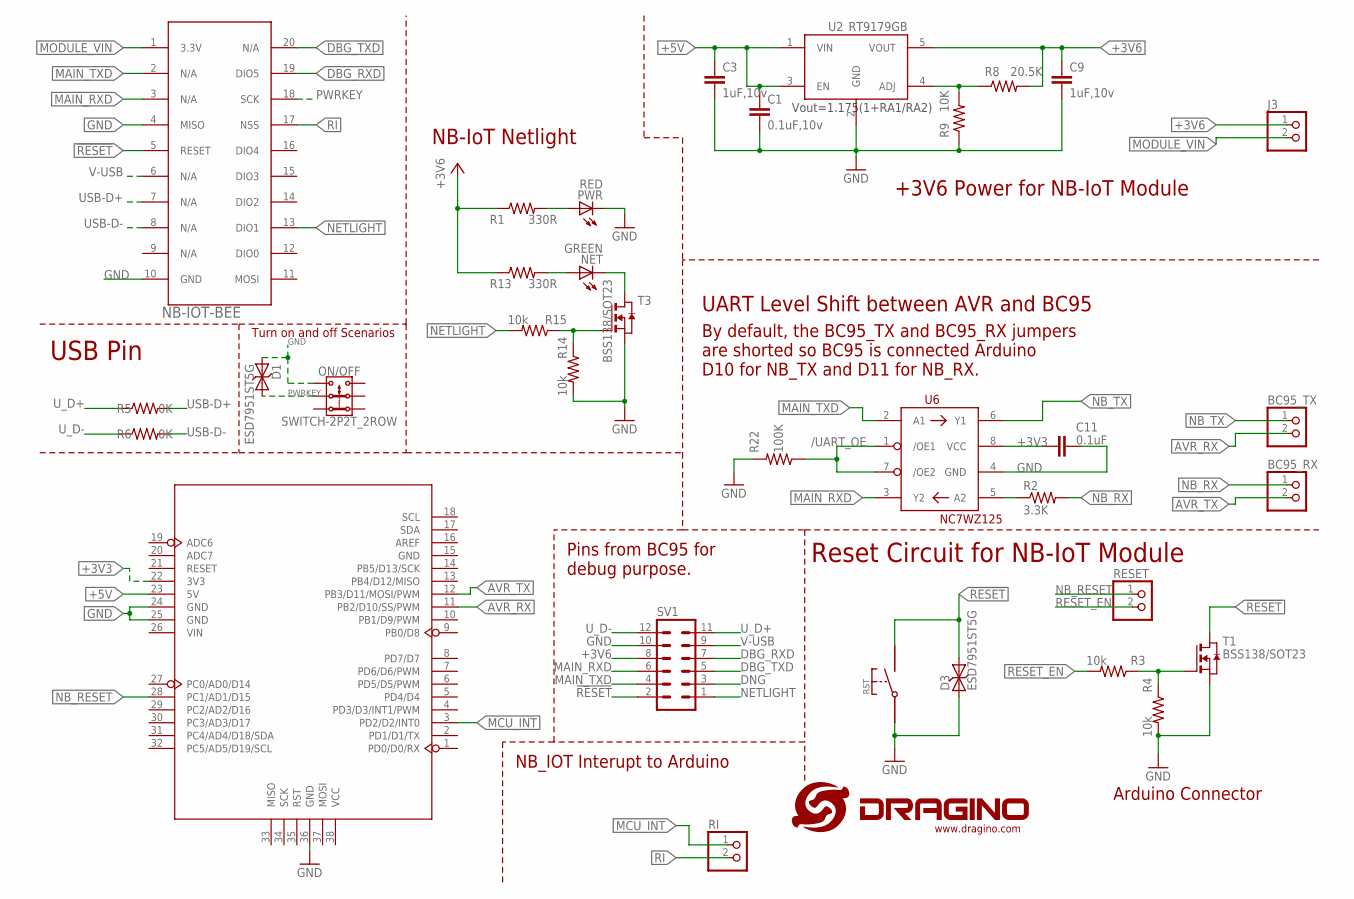
[picture p29: schematic IoT Shield.v1.2.sch]

Parts:
BC95_RX, BC95_TX: PINHD-1X2; 1X02
C1: 0.1uF,10v; C0402
C3, C9: 1uF,10v; C0402
C11: 0.1uF; C0402
D1, D3: ESD7951ST5G; SOD−923
IOT-BEE: NB-IOT-BEE; LORA
J3: PINHD-1X2; 1X02
NET: GREEN; CHIP-LED0603
ON/OFF: SWITCH-2P2T_2ROW; KFT7.0-7X7
PWR: RED; CHIP-LED0603
R1, R13: 330R; R0402
R2: 3.3K; R0402
R3, R4, R14, R15: 10k; R0402
R5, R6: 0K; R0402
R8: 20.5K; R0402
R9: 10K; R0402
R22: 100K; R0402
RESET: PINHD-1X2; 1X02
RI: PINHD-1X2; 1X02
RST: SWITCHTS-16; TS-016
SV1: MA06-2
T1, T3: BSS138/SOT23; SOT-23
U2: RT9179GB; SOT23-5
U5: MOUDLE_ARDUINO-38PMOUDLE_ARDUINO-38P_L; MOUDLE_ARDUINO-38P_L
U6: NC7WZ125; US8
U$1: LOGO-NEW; LOGO-SILK-NEW

Connections:
!RESET: D3.P$2 (2), IOT-BEE.5 (RESET), RST.P$2, SV1.2, T1.1 (D)
+3V3: C11.2, U5.22 (3V3), U6.8 (VCC)
+3V6: C9.1, J3.1, R1.1, R8.2, R13.1, SV1.8, U2.5 (VOUT)
+5V: C1.1, C3.1, U2.1 (VIN), U2.3 (EN), U5.23 (5V)
/UART_OE: R22.1, U6.1 (/OE1), U6.7 (/OE2)
AVR_RX: BC95_TX.2, U5.11 (PB2/D10/SS/PWM)
AVR_TX: BC95_RX.2, U5.12 (PB3/D11/MOSI/PWM)
DBG_RXD: IOT-BEE.19 (DIO5), SV1.7
DBG_TXD: IOT-BEE.20 (N/A), SV1.5
DNG: SV1.3
GND: C1.2, C3.2, C9.2, C11.1, D1.P$1 (1), D3.P$1 (1), IOT-BEE.4 (MISO), IOT-BEE.10 (GND), ON/OFF.3.1, PWR.C, R4.2, R9.1, R14.2, R22.2, RST.P$1, SV1.10, T1.2 (S), T3.2 (S), U2.2 (GND), U5.24 (GND), U5.25 (GND), U5.36 (GND), U6.4 (GND)
MAIN_RXD: IOT-BEE.3 (N/A), SV1.6, U6.3 (Y2)
MAIN_TXD: IOT-BEE.2 (N/A), SV1.4, U6.2 (A1)
MCU_INT: RI.1, U5.3 (PD2/D2/INT0)
MODULE_VIN: IOT-BEE.1 (3.3V), J3.2
unnamed: R3.1, R4.1, T1.3 (G)
unnamed: PWR.A, R1.2
unnamed: NET.A, R13.2
unnamed: NET.C, T3.1 (D)
unnamed: R14.1, R15.1, T3.3 (G)
unnamed: R8.1, R9.2, U2.4 (ADJ)
unnamed: R2.1, U6.5 (A2)
NB_RESET: RESET.1, U5.28 (PC1/AD1/D15)
NB_RX: BC95_RX.1, R2.2
NB_TX: BC95_TX.1, U6.6 (Y1)
NETLIGHT: IOT-BEE.13 (DIO1), R15.2, SV1.1
PWRKEY: D1.P$2 (2), IOT-BEE.18 (SCK), ON/OFF.2.1
RESET_EN: R3.2, RESET.2
RI: IOT-BEE.17 (NSS), RI.2
USB-D+: IOT-BEE.7 (N/A), R5.2
USB-D-: IOT-BEE.8 (N/A), R6.2
U_D+: R5.1, SV1.11
U_D-: R6.1, SV1.12
V-USB: IOT-BEE.6 (N/A), SV1.9

Notes on the sheet:
Arduino Connector
By default, the BC95_TX and BC95_RX jumpers are shorted so BC95 is connected Arduino D10 for NB_TX and D11 for NB_RX.
Reset Circuit for NB-IoT Module
UART Level Shift between AVR and BC95
NB_IOT Interupt to Arduino
+3V6 Power for NB-IoT Module
Pins from BC95 for debug purpose.
NB-IoT Netlight
USB Pin
Turn on and off Scenarios

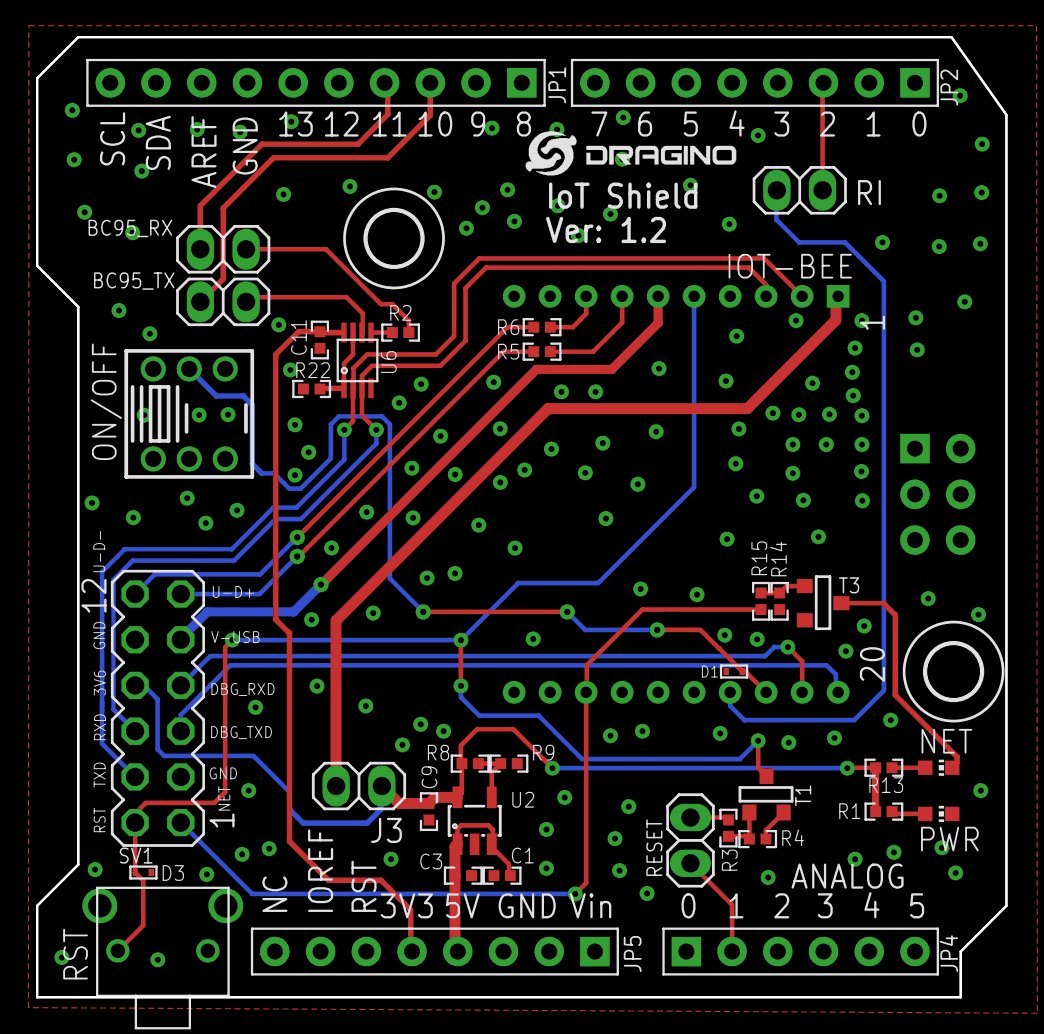
[picture p30: board IoT Shield.v1.2.brd from above]

Board: 2 copper layers, 53.8 x 53.3 mm, 37 parts (0 on the bottom side), 33 nets.

Other parts of the board:
U$2, U$3: 3,0
