dragino/NB-IoT/NB-IoT Shield/hardware/NB-IoT Bee/v96_5/NB-IoT Bee.v96_5.brd

## EAGLE design NB-IoT Shield/hardware/NB-IoT Bee/v96_5/NB-IoT Bee.v96_5.brd (2020-01-30)

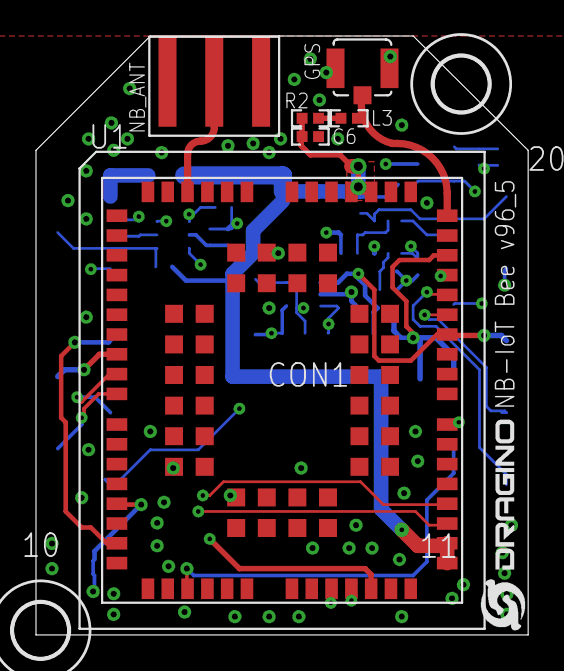
[picture p31: board NB-IoT Bee.v96_5.brd from above]

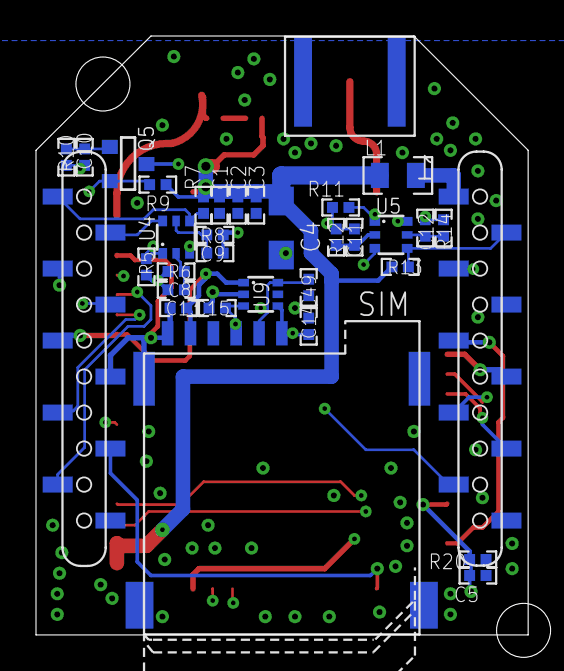
[picture p32: board NB-IoT Bee.v96_5.brd from below]

Board: 4 copper layers, 27.3 x 33.3 mm, 41 parts (31 on the bottom side), 33 nets.

Parts:
C1: 22pF; C0402
C2: 100pF; C0402
C3: 0.1uF; C0402
C4: 100uF, 6.3v,钽电容; SMC_A
C5: 0.01u; C0402
C6, C13: 0.1u; C0402
C8, C9, C10, C11, C12: 1nf; C0402
C14, C15, C49: 33pF; C0402
CON1: BEE-SOCKET
GPS: I-PEX
L1: PZ2012D301-1R5TF; C0805
L3: 47nH; C0402
NB_ANT: NL; SMA-KE
Q5: BSS138-7-F; SOT-23
R2: 10R; R0402
R5, R11, R20: 10k; R0402
R6, R8, R10, R12, R14: 4.7k; R0402
R7, R9, R13: 10K; R0402
SIM: SIM_CARD_CON_6MICRO; SIM-MICRO-PUSH
U1: BG96
U4, U5: 2N7002KDW; SOT363-NXP
U9: SMF05C; SOT363
U$1: LOGO-NEW; LOGO-SILK-NEW
U$2, U$3: 3,0

Connections:
!RESET: CON1.5, U1.17
GND: C1.2, C2.2, C3.2, C4.-, C5.1, C6.2, C14.2, C15.2, C49.2, CON1.4, CON1.10, CON1.11, GPS.GND, GPS.GND1, NB_ANT.P$1, NB_ANT.P$2, NB_ANT.P$3, NB_ANT.P$4, R20.2, U1.3, U1.48, U1.50, U1.54, U1.55, U1.58, U1.59, U1.61, U1.62, U1.67, U1.68, U1.69, U1.70, U1.71, U1.72, U1.73, U1.74, U1.79, U1.80, U1.81, U1.82, U1.89, U1.90, U1.91, U1.100, U1.101, U1.102, U9.2
GPS_RXD: CON1.19, U4.6
GPS_TXD: CON1.20, R7.2, U4.4
MAIN_RXD: CON1.3, U5.6
MAIN_TXD: CON1.2, R13.2, U5.4
unnamed: C8.2, R6.2, U4.2
unnamed: L3.1, R2.1
unnamed: C9.2, R8.2, U4.5
unnamed: C10.2, Q5.3, R10.2
unnamed: C12.2, R14.2, U5.5
unnamed: C11.2, R12.2, U5.2
unnamed: GPS.SIG, L3.2, U1.49
NETLIGHT: CON1.13, U1.21
PWRKEY: C5.2, CON1.18, R20.1, U1.15
RF_ANT: NB_ANT.P$5, U1.60
RI: CON1.17, Q5.2, R9.2
RI1: Q5.1, U1.39
UART1_RXD: R11.2, U1.34, U5.1
UART1_TXD: U1.35, U5.3
UART3_RXD: R5.2, U1.28, U4.1
UART3_TXD: U1.27, U4.3
USB_N: CON1.8, U1.10
USB_P: CON1.7, U1.9
USB_VBUS: CON1.6, U1.8
USIM_CLK: C14.1, CON1.9, SIM.CLK, U1.46, U9.4
USIM_DATA: C49.1, CON1.12, SIM.IO, U1.45, U9.6
USIM_GND: C13.2, CON1.15, SIM.GND, SIM.P$1, SIM.P$2, SIM.P$3, SIM.P$4, U1.47
USIM_RST: C15.1, CON1.14, SIM.RST, U1.44, U9.3
USIM_VDD: C13.1, CON1.16, SIM.VCC, U1.43, U9.1
VBAT: C1.1, C2.1, C3.1, C4.+, C6.1, L1.1, R2.2, R7.1, R9.1, R13.1, U1.32, U1.33, U1.52, U1.53
VDD_18: C8.1, C9.1, C10.1, C11.1, C12.1, R5.1, R6.1, R8.1, R10.1, R11.1, R12.1, R14.1, U1.29
VIN: CON1.1, L1.2
