dragino/NB-IoT/NB-IoT Shield/hardware/NB-IoT Bee/v1.0/NB-IoT Bee.v1.0.brd

## EAGLE design NB-IoT Shield/hardware/NB-IoT Bee/v1.0/NB-IoT Bee.v1.0.brd (2018-04-17, an earlier design)

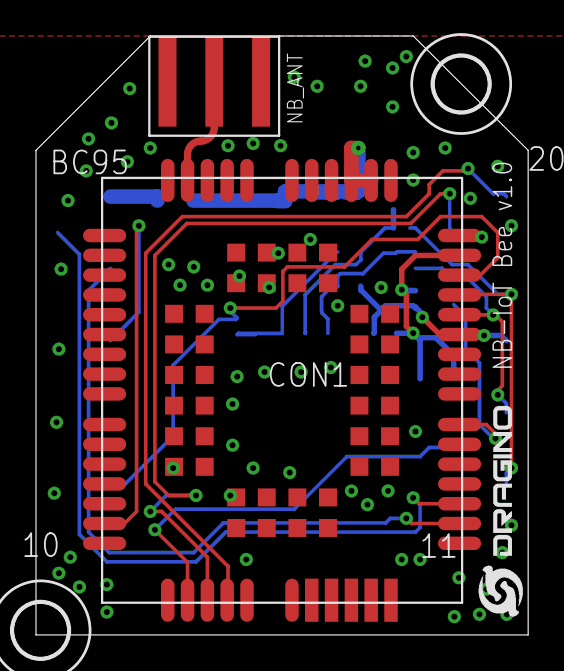
[picture p33: board NB-IoT Bee.v1.0.brd from above]

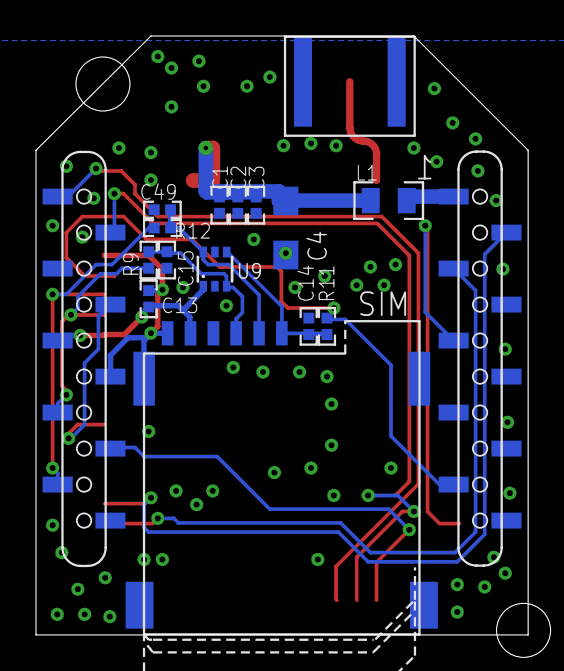
[picture p34: board NB-IoT Bee.v1.0.brd from below]

Board: 2 copper layers, 27.3 x 33.3 mm, 20 parts (14 on the bottom side), 19 nets.

Parts:
BC95: BC90
C1: 22pF; C0402
C2: 100pF; C0402
C3: 0.1uF; C0402
C4: 100uF, 6.3v,钽电容; SMC_A
C13: 0.1u; C0402
C14, C15, C49: 33pF; C0402
CON1: BEE-SOCKET
L1: PZ2012D301-1R5TF; C0805
NB_ANT: NL; SMA-KE
R9, R11, R12: 22R; R0402
SIM: SIM_CARD_CON_6MICRO; SIM-MICRO-PUSH
U9: SMF05C; SOT363
U$1: LOGO-NEW; LOGO-SILK-NEW
U$2, U$3: 3,0

Connections:
!RESET: BC95.15, CON1.5
DBG_RXD: BC95.19, CON1.19
DBG_TXD: BC95.20, CON1.20
GND: BC95.2, BC95.43, BC95.47, BC95.48, BC95.51, BC95.52, BC95.54, BC95.59, BC95.60, BC95.61, BC95.62, BC95.63, BC95.64, BC95.65, BC95.66, BC95.71, BC95.72, BC95.73, BC95.74, BC95.81, BC95.82, BC95.83, BC95.92, BC95.93, BC95.94, C1.2, C2.2, C3.2, C4.-, C14.2, C15.2, C49.2, CON1.4, CON1.10, CON1.11, NB_ANT.P$1, NB_ANT.P$2, NB_ANT.P$3, NB_ANT.P$4, U9.2
MAIN_RXD: BC95.29, CON1.3
MAIN_TXD: BC95.30, CON1.2
NETLIGHT: BC95.18, CON1.13
RF_ANT: BC95.53, NB_ANT.P$5
RI: BC95.34, CON1.17
SIM_CLK1: C14.1, R11.1, SIM.CLK, U9.4
SIM_DATA1: C49.1, R12.1, SIM.IO, U9.6
SIM_RST1: C15.1, R9.1, SIM.RST, U9.3
USIM_CLK: BC95.41, CON1.9, R11.2
USIM_DATA: BC95.40, CON1.12, R12.2
USIM_GND: BC95.42, C13.2, CON1.15, SIM.GND, SIM.P$1, SIM.P$2, SIM.P$3, SIM.P$4
USIM_RST: BC95.39, CON1.14, R9.2
USIM_VDD: BC95.38, C13.1, CON1.16, SIM.VCC, U9.1
VIN: CON1.1, L1.2
VIN1: BC95.45, BC95.46, C1.1, C2.1, C3.1, C4.+, L1.1
