dragino/NB-IoT/(commit log)

2018-04-17 Update NB-IoT Shield hardware source
    [IoT Shield.v1.0.brd, IoT Shield.v1.0.sch, NB-IoT Bee.v1.0.brd]
2018-07-10 Add NB-IoT-Bee QB86
    [NB-IoT Bee.v96_3.brd]
2019-05-09 Update QG96 v96_4 version
    [NB-IoT Bee.v96_4.brd]
2020-01-30 Update Bee-bg96_v5
    [NB-IoT Bee.v96_5.brd]
2021-01-21 Update to v1.2
    [IoT Shield.v1.2.brd, IoT Shield.v1.2.sch]
