dragino/NB-IoT/(notices)

Notices in the files:
parts and their libraries:
dragino: http://creativecommons.org/licenses/by-sa/3.0
dragino: Released under the CC Attribution Share-Alike 3.0 License
